arvtom/uwb_trac/README.md

# uwb_trac
My BA thesis: beacon based object tracking using UAV. Navigation is performed using UWB distance measurement. Quadcopter altitude, distance and angle to beacon is controlled using PID algorithm. Flight data is displayed in real time on a LCD display and saved to a microSD card.  

Summary can be found in .pdf slides.

Navigation diagram  
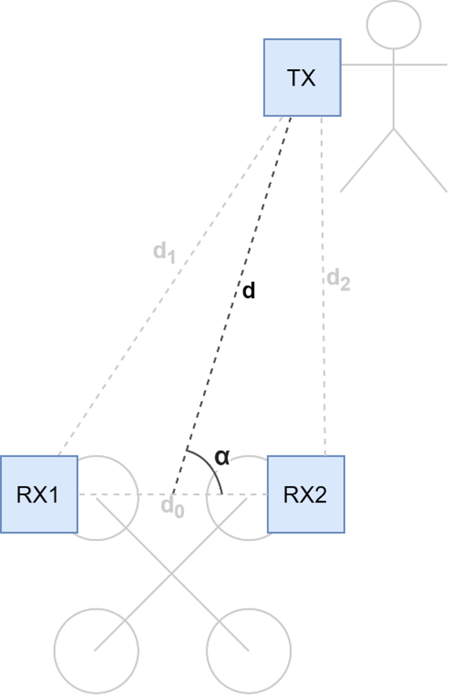
[picture p1: navigation_diagram.png]
  

HW bock diagram  
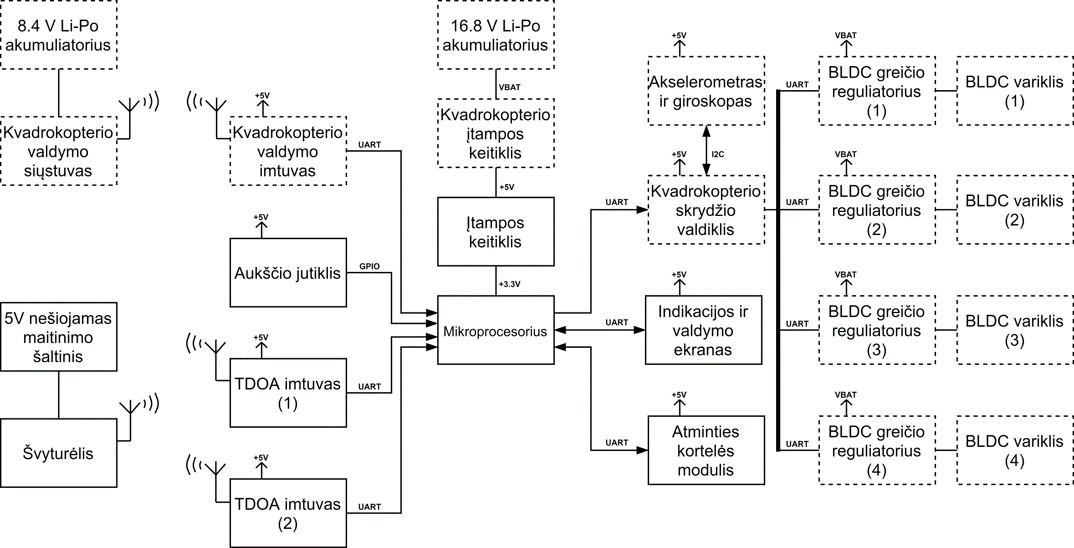
[picture p2: hw_block_diagram.png]
  

PCBA  
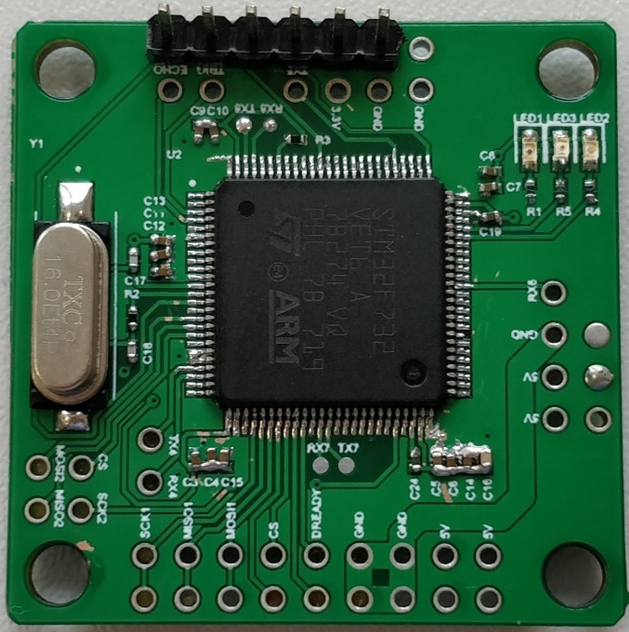
[picture p3: pcba.jpg]
  

Equipment  
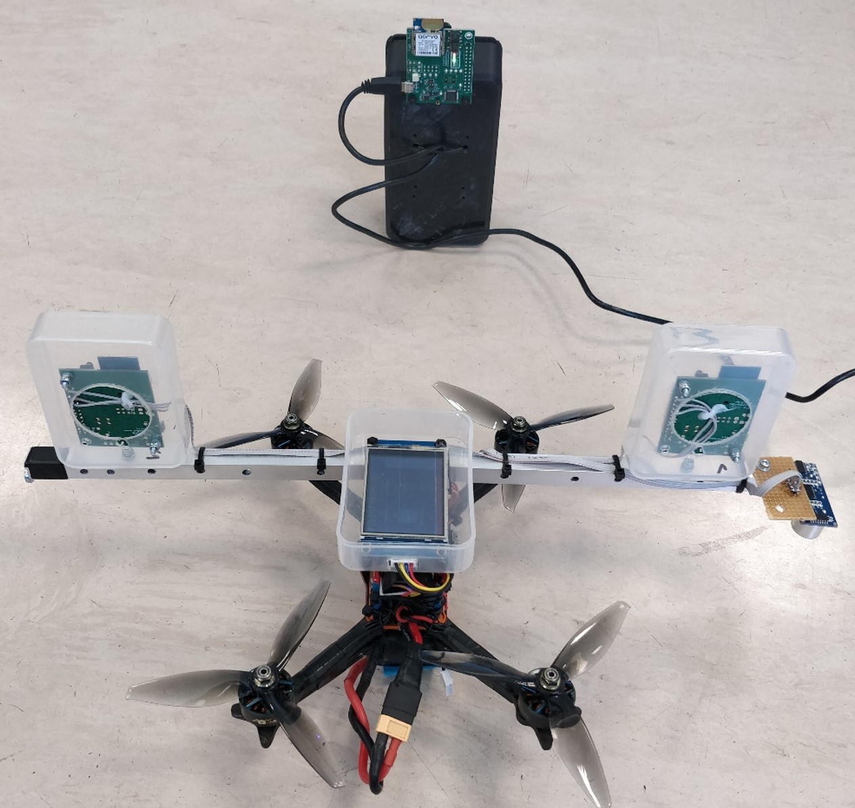
[picture p4: equipment.jpg]
