arvtom/uwb_trac/Objekto su švyturėliu sekimas naudojant bepilotį orlaivį_slides.pdf

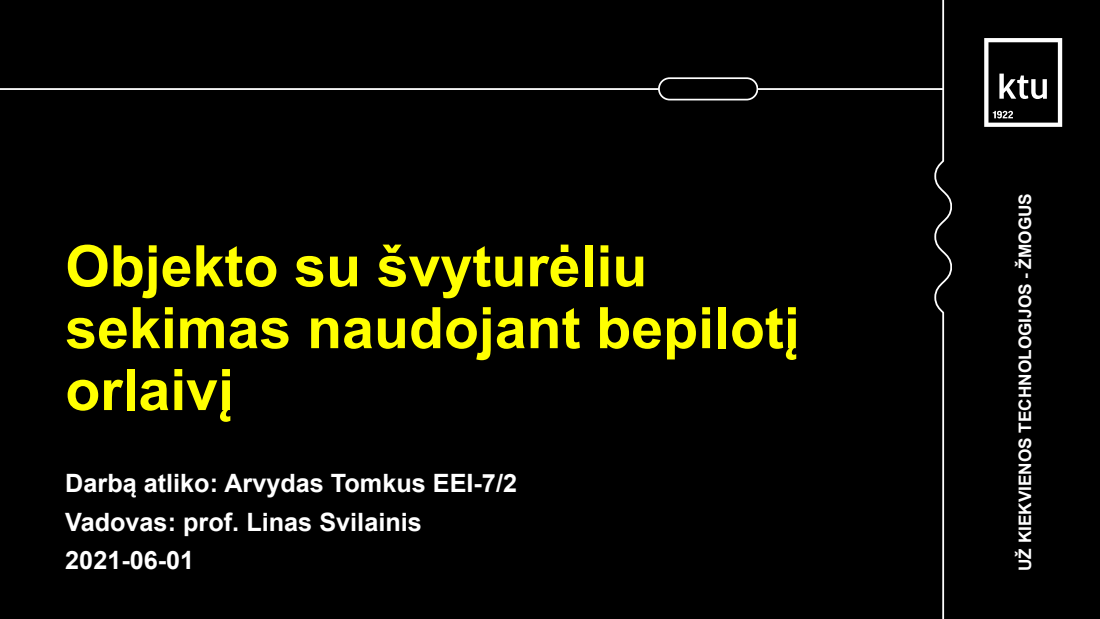
[picture p5: page 1]

UŽ KIEKVIENOS TECHNOLOGIJOS - ŽMOGUS

Objekto su švyturėliu
sekimas naudojant bepilotį
orlaivį

Darbą atliko: Arvydas Tomkus EEI
Vadovas: prof. Linas Svilainis

## Darbo tikslas ir užduotys

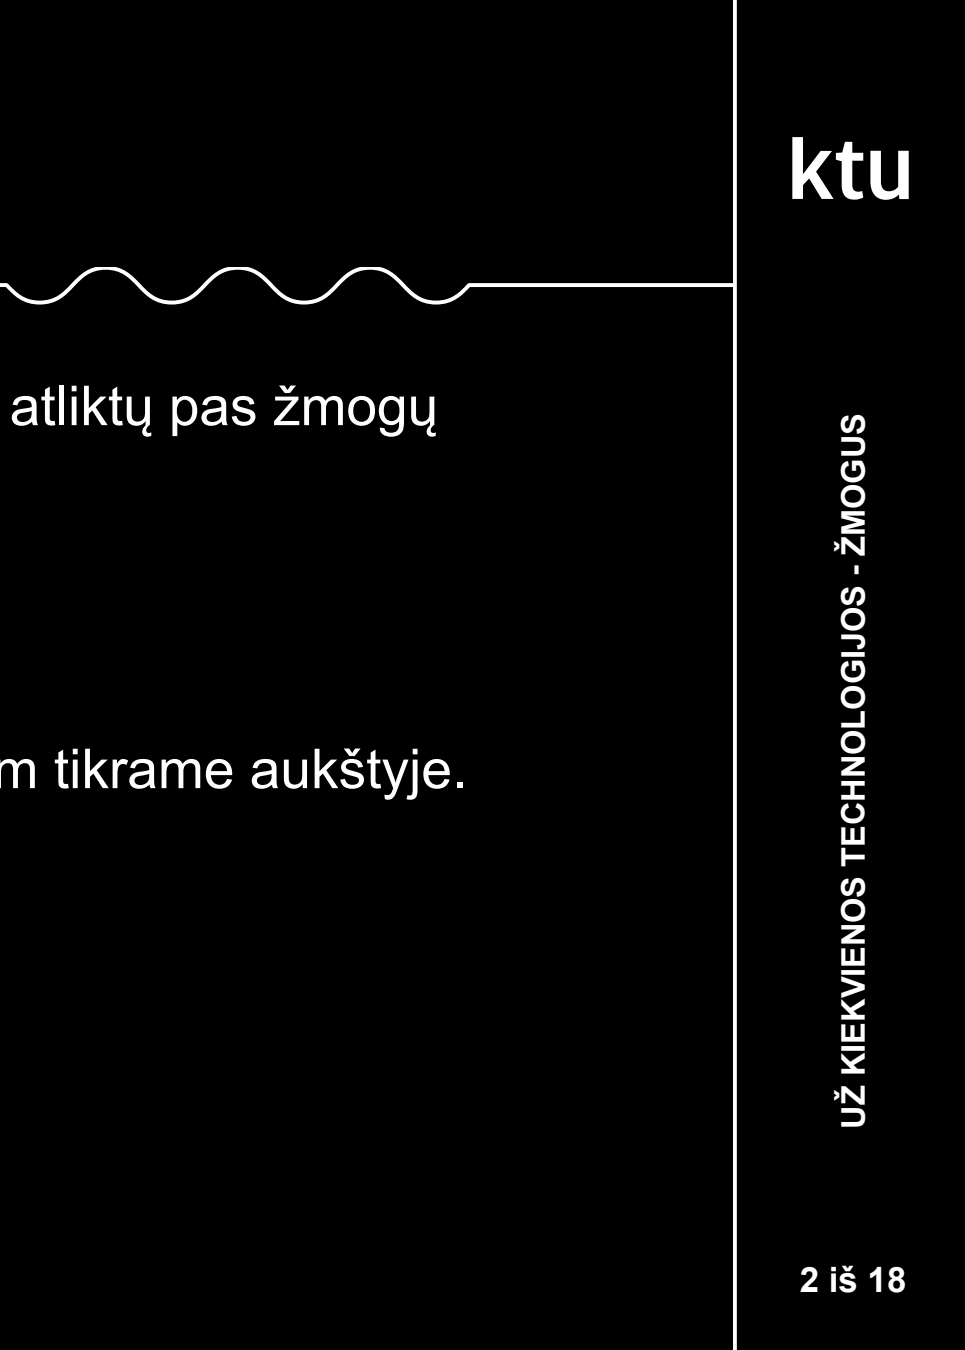
[picture p6: figure]
UŽ KIEKVIENOS TECHNOLOGIJOS - ŽMOGUS

Suprojektuoti kvadrokopterį papildančią sistemą, kuri atliktų pas žmogų prisegto švyturėlio sekimą.

1. Išmatuoti atstumą ir kampą į švyturėlį
2. Išmatuoti orlaivio aukštį
3. Užtikrinti švyturėlio sekimą tam tikru atstumu ir tam tikrame aukštyje.

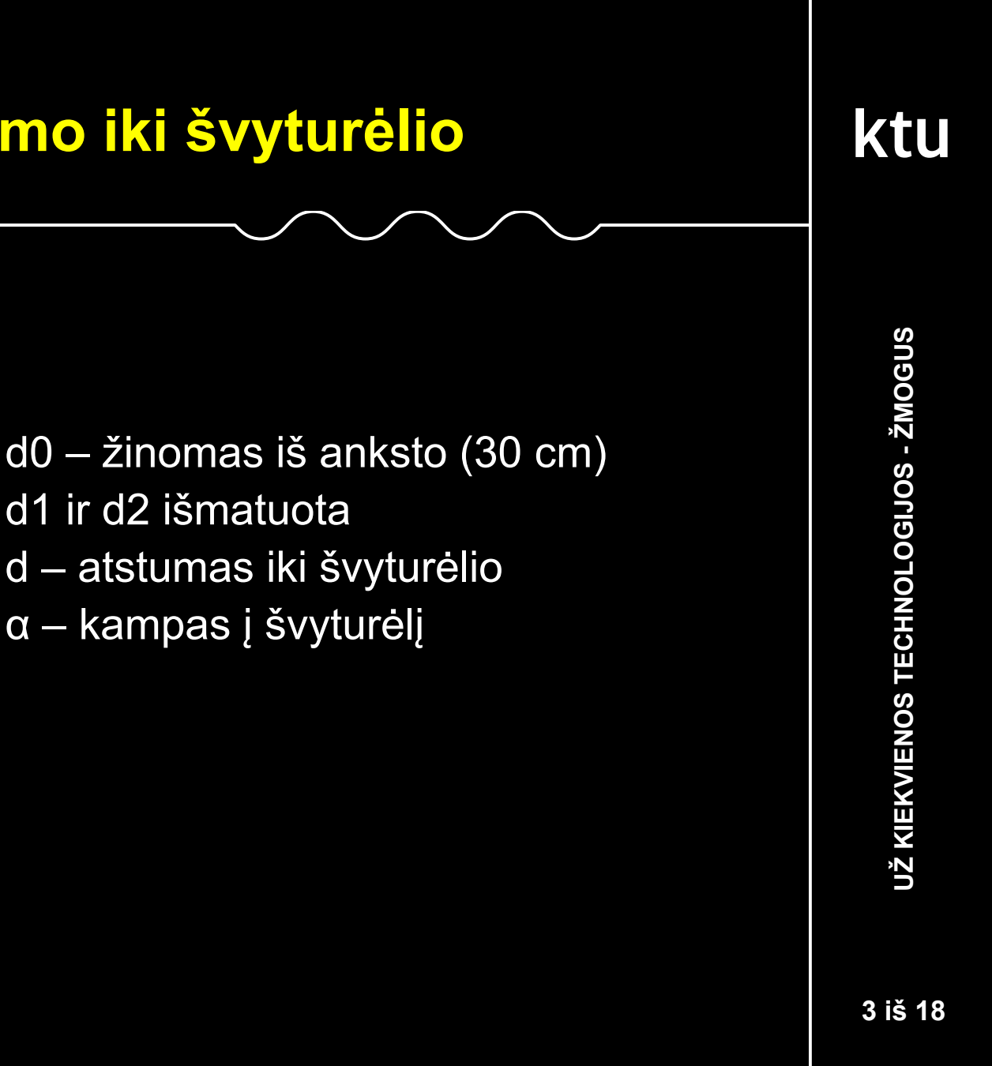
[picture p7: figure]
UŽ KIEKVIENOS TECHNOLOGIJOS - ŽMOGUS; d0 – žinomas iš anksto (30 cm) d1 ir d2 išmatuota d – atstumas iki švyturėlio α – kampas į švyturėlį

## Užduotis (1). Kampo ir atstumo iki švyturėlio matavimas

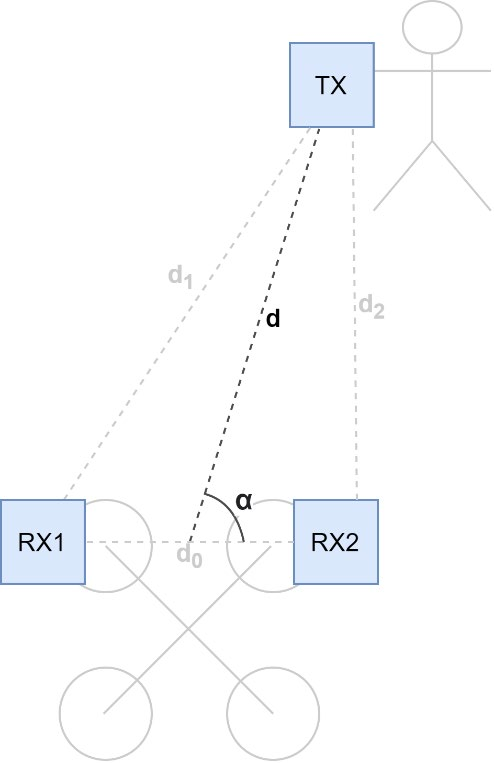
[picture p8: figure]

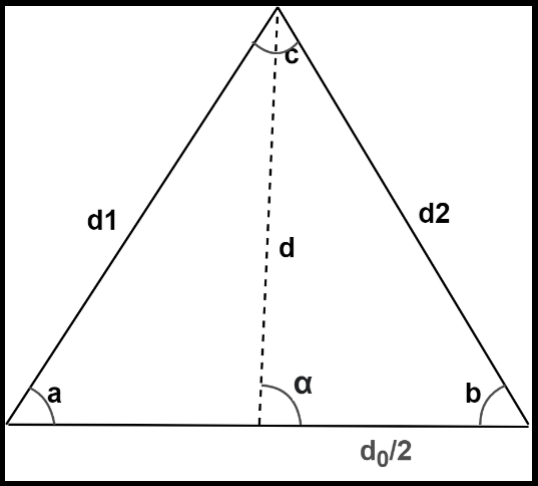
[picture p9: figure]
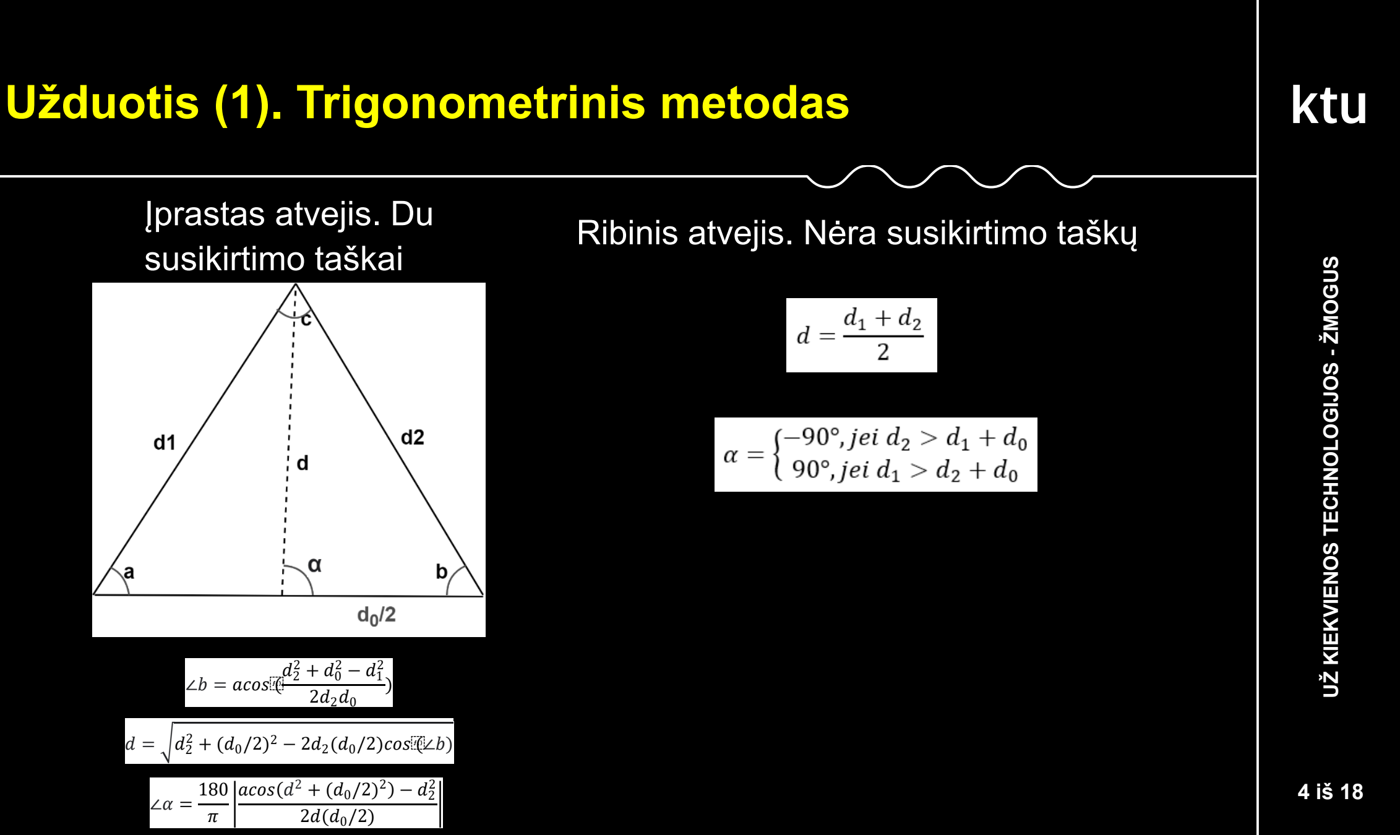
[picture p10: figure]
Užduotis (1). Trigonometrinis metodas; UŽ KIEKVIENOS TECHNOLOGIJOS - ŽMOGUS; ∠bb = aaaaaaaa⁡(; aaaaaaaa(dd2 + (dd0/2)2) − dd2 2 2dd(dd0/2) ; Įprastas atvejis. Du; susikirtimo taškai; Ribinis atvejis. Nėra susikirtimo taškų

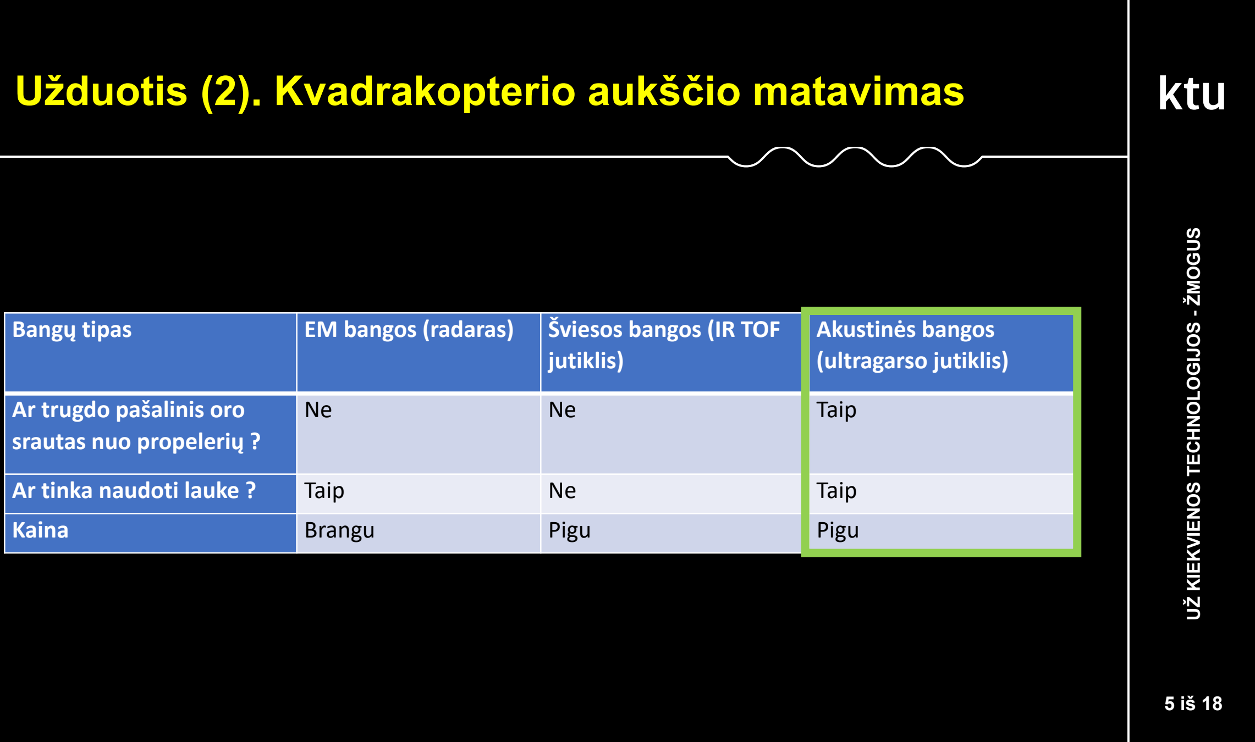
[picture p11: figure]
UŽ KIEKVIENOS TECHNOLOGIJOS - ŽMOGUS; Bangų tipas; EM bangos (radaras); Šviesos bangos (IR TOF jutiklis); Akustinės bangos (ultragarso jutiklis); Ar tinka naudoti lauke ?; Taip; Kaina; Brangu; Pigu

## Užduotis (2). Kvadrakopterio aukščio matavimas

Ar trugdo pašalinis oro srautas nuo propelerių ? | Ne | Ne | Taip

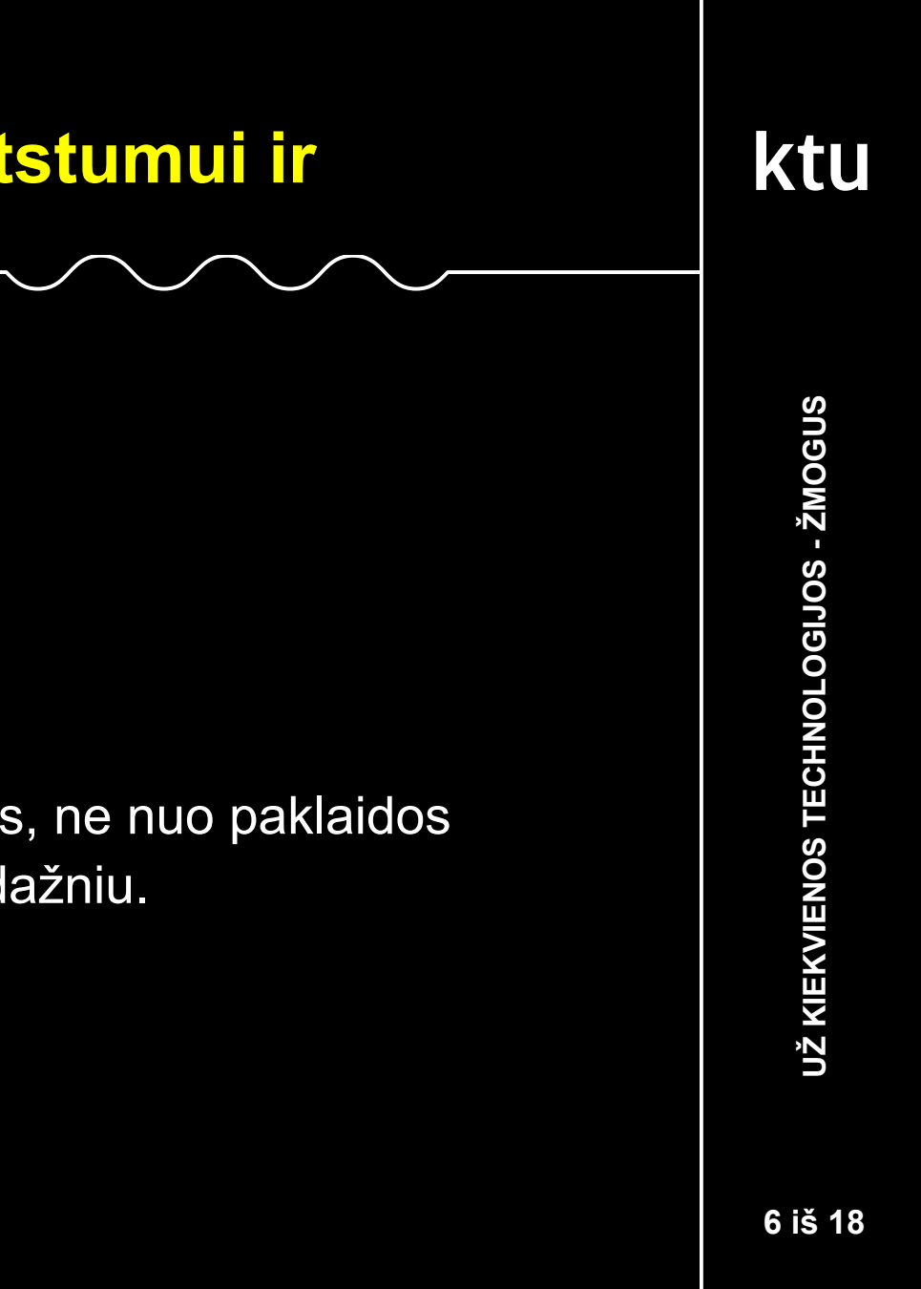
[picture p12: figure]
UŽ KIEKVIENOS TECHNOLOGIJOS - ŽMOGUS

## Užduotis (3). PID valdiklis kampui, atstumui ir aukščiui

Papildomai:
1. Apribotas PID išėjimas
2. Apribota integralo suma
3. D dedamoji skaičiuojama nuo išmatuotos vertės, ne nuo paklaidos
4. LPF D dedamosios išėjime, su 20 Hz „cut off“ dažniu.

## Sistemos struktūrinė schema

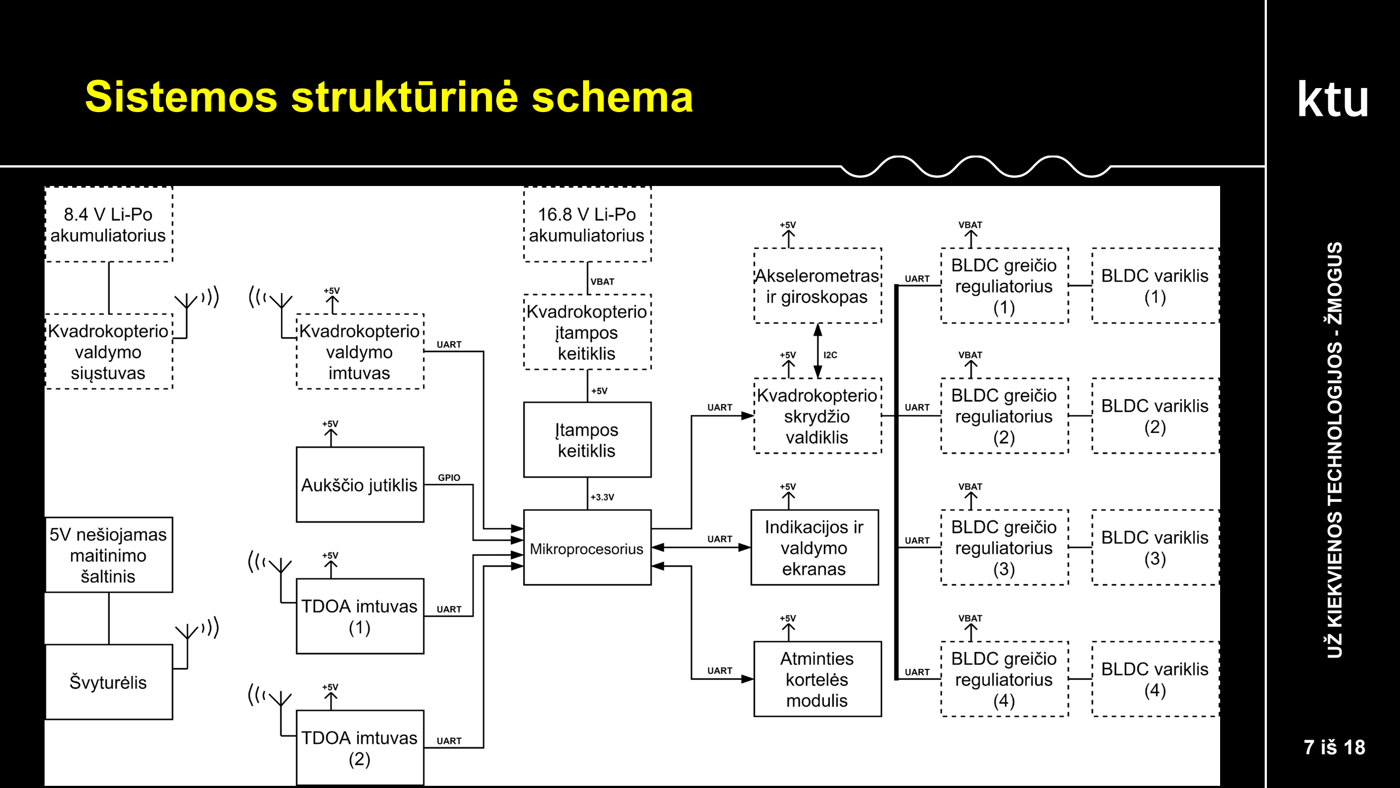
[picture p13: page 7]

7

iš 18

UŽ KIEKVIENOS TECHNOLOGIJOS - ŽMOGUS

### 8 iš 18

## Komponentų pasirinkimas (1). UWB modulis ir ultragarso jutiklis

UŽ KIEKVIENOS TECHNOLOGIJOS - ŽMOGUS

Pavadinimas | „BU01“ | „DWM1001-DEV“ | „Pozyx developer tag“
Maksimalus atstumas, m | - | 300 | 60
Atsitiktinė paklaida, cm | 10 | 10 | 10
Sąsaja | „SPI“ | „UART“, „SPI“, „Bluetooth“ | „UART“, „I2C“
Diskretizavimo dažnis, Hz | 10 | 10 | 10
Papildomi jutikliai | - | Akselerometras | Akselerometras, giroskopas, kompasas
Plėtojimo plokštės kaina, Eur | 18 | 20 | 135
Atskiro modulio kaina, Eur | 10 | 25 | -
Pavadinimas | HC-SR04 | GY-US42 | EV_MOD_CH101-01-02
Maksimalus atstumas, m | 4 | 7.5 | 1.2
Atsitiktinė paklaida, mm | 3 | 10 | 1
Matymo kampas, ° | 15 | 10 | 45
Sąsaja | „PWM“ | „I2C“, „UART“, „PWM“ | „I2C“
Diskretizavimo dažnis, Hz | 16 | 15 | 100
Kaina, Eur | 3.5 | 7 | 18

### 9 iš 18

## Komponentų pasirinkimas (2). Mikroprocesorius

UŽ KIEKVIENOS TECHNOLOGIJOS - ŽMOGUS
Pavadinimas | „STM32L053C8U6“ | „STM32F303ZDT6“ | „STM32F732VET6“
Taktinis dažnis, MHz | 32 | 72 | 216
Taimerių kiekis | 9 | 14 | 18
Laikinoji atmintis, kB | 8 | 64 | 256
Flash atmintis, kB | 64 | 512 | 512
„SPI“ kiekis | 4 | 4 | 5
„UART“ kiekis | 2 | 5 | 4
Palaiko „UART“ priėmimo loginį invertavimą | Taip | Taip | Taip
Korpusas | „LQFP-48“ | „LQFP-144“ | „LQFP-100“
Kaina, Eur | 3.25 | 7.91 | 8.79

### 10 iš 18

## Komponentų pasirinkimas (3). Ekranas ir atminties kortelė

UŽ KIEKVIENOS TECHNOLOGIJOS - ŽMOGUS

Pavadinimas | „AST1032“ | „NX3224T024“
Istrižainė, coliai | 0.96 | 2.4
Technologija | OLED | TFT LCD
Valdymo sąsaja | „I2C“ | „UART“
Rezoliucija | 128x64 | 320x240
Srovės suvartojimas, mA | 15 | 90
Lietimo sensorius | - | Yra
Kaina, Eur | 6.55 | 18
Pavadinimas | „Adafruit MicroSD card breakout board+“ | „Sparkfun Openlog“
Valdymo sąsaja | „SPI“ | „UART“
Maksimalus greitis | - | 115.2 kbit/s
Palaikoma failų sistema | „FAT16“, „FAT32“ | „FAT16“, „FAT32“
Kaina, Eur | 6.55 | 18

## Spausdinto montažo plokštė

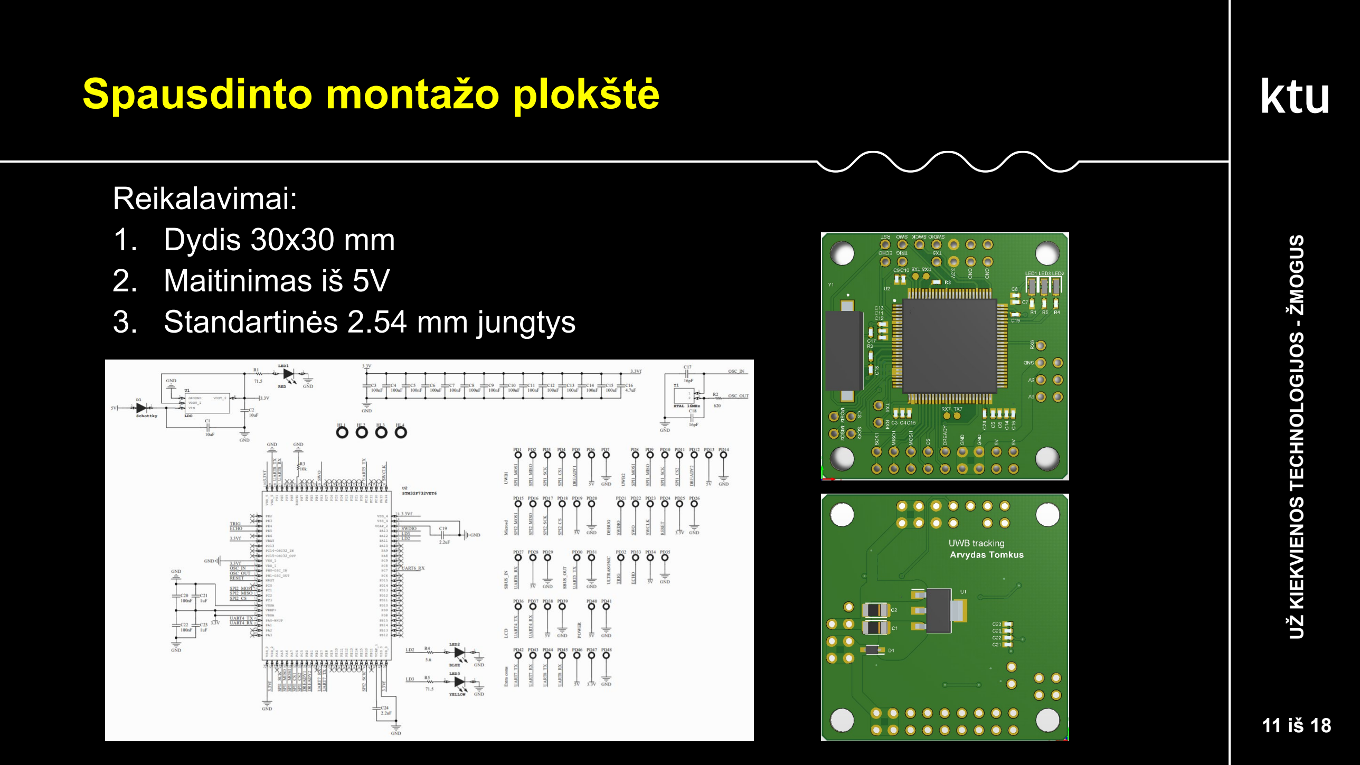
[picture p14: page 11]

11

iš 18

UŽ KIEKVIENOS TECHNOLOGIJOS - ŽMOGUS

Reikalavimai:
1. Dydis 30x30 mm
2. Maitinimas

iš 5V
3. Standartinės 2.54 mm jungtys

## Programinis algoritmas

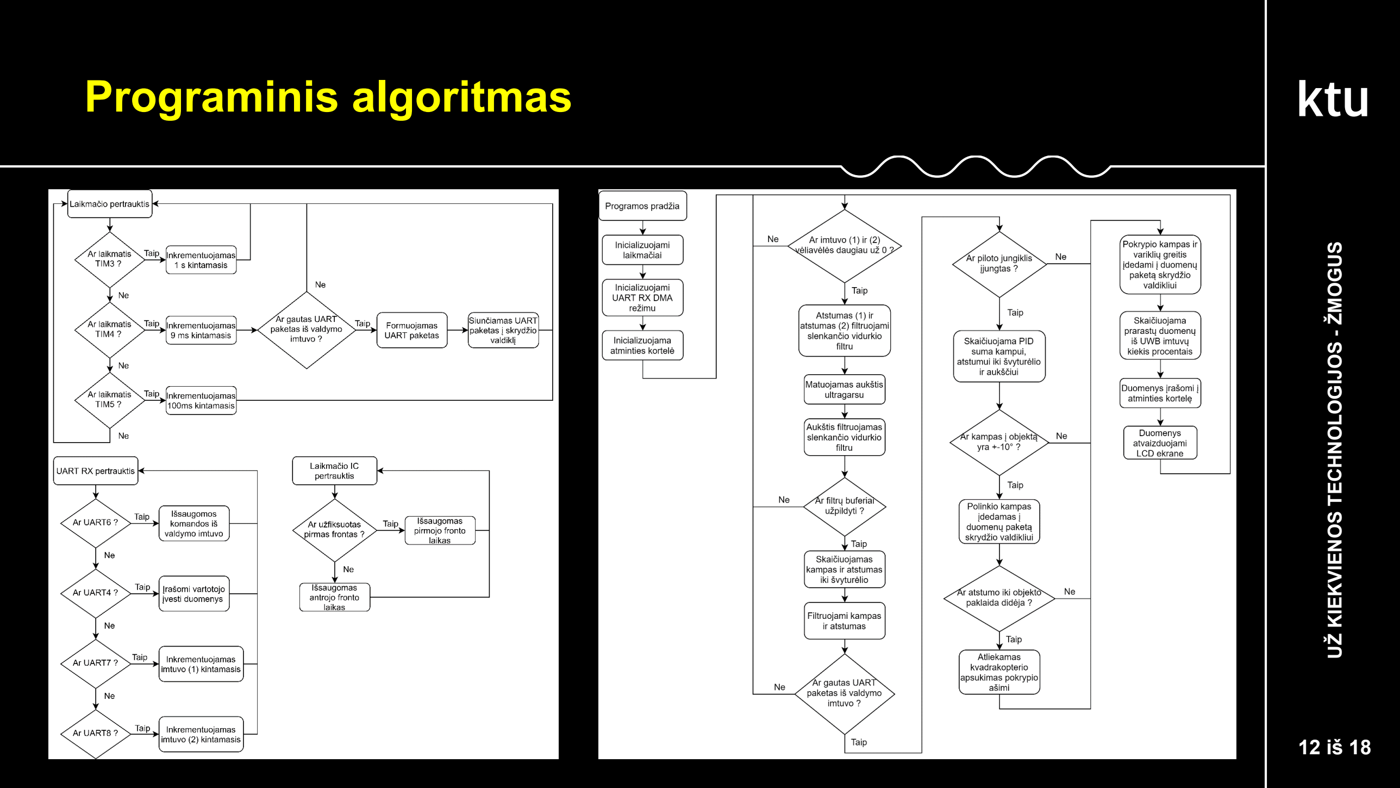
[picture p15: page 12]

12

iš 18

UŽ KIEKVIENOS TECHNOLOGIJOS - ŽMOGUS

## Rezultatai (1)

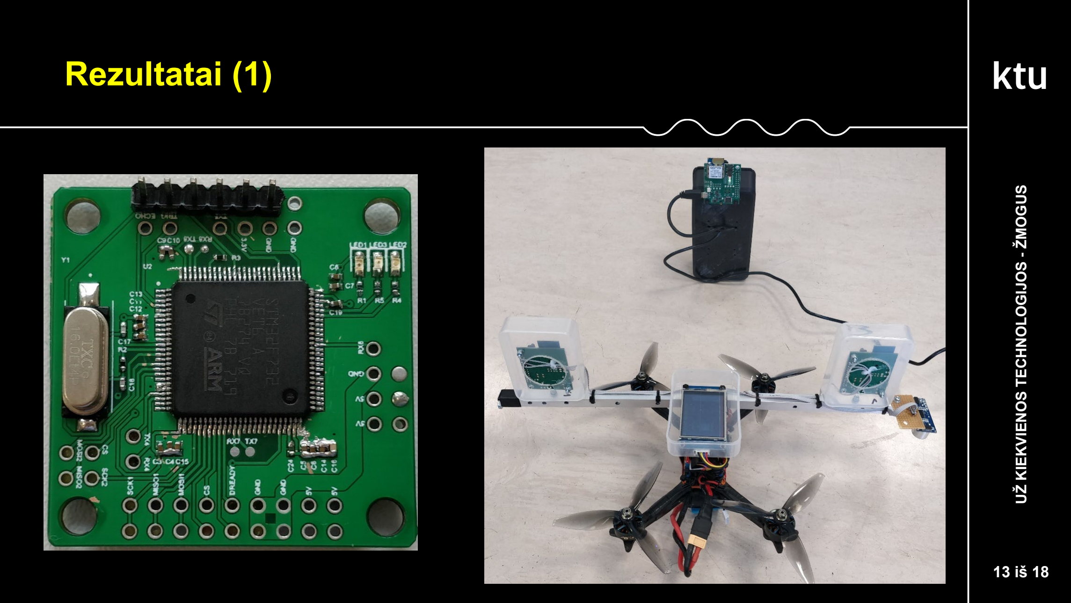
[picture p16: page 13]

13

iš 18

UŽ KIEKVIENOS TECHNOLOGIJOS - ŽMOGUS

## Rezultatai (2). Praktinės paklaidos

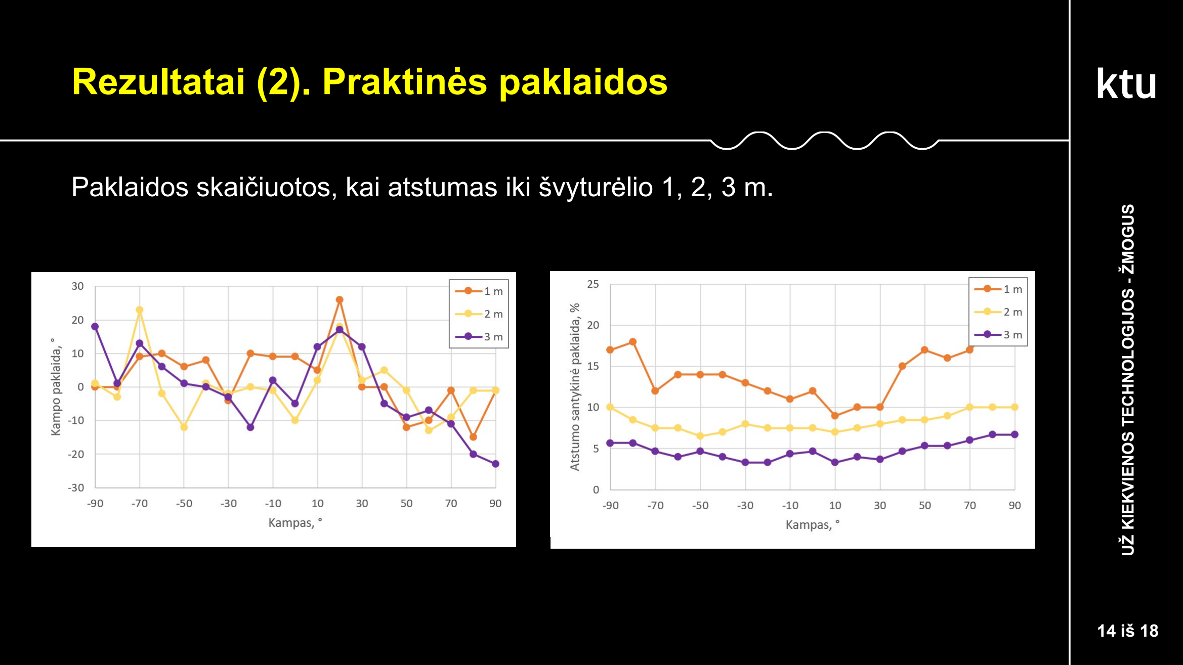
[picture p17: page 14]

14

iš 18

UŽ KIEKVIENOS TECHNOLOGIJOS - ŽMOGUS

Paklaidos skaičiuotos, kai atstumas iki švyturėlio 1, 2, 3 m.

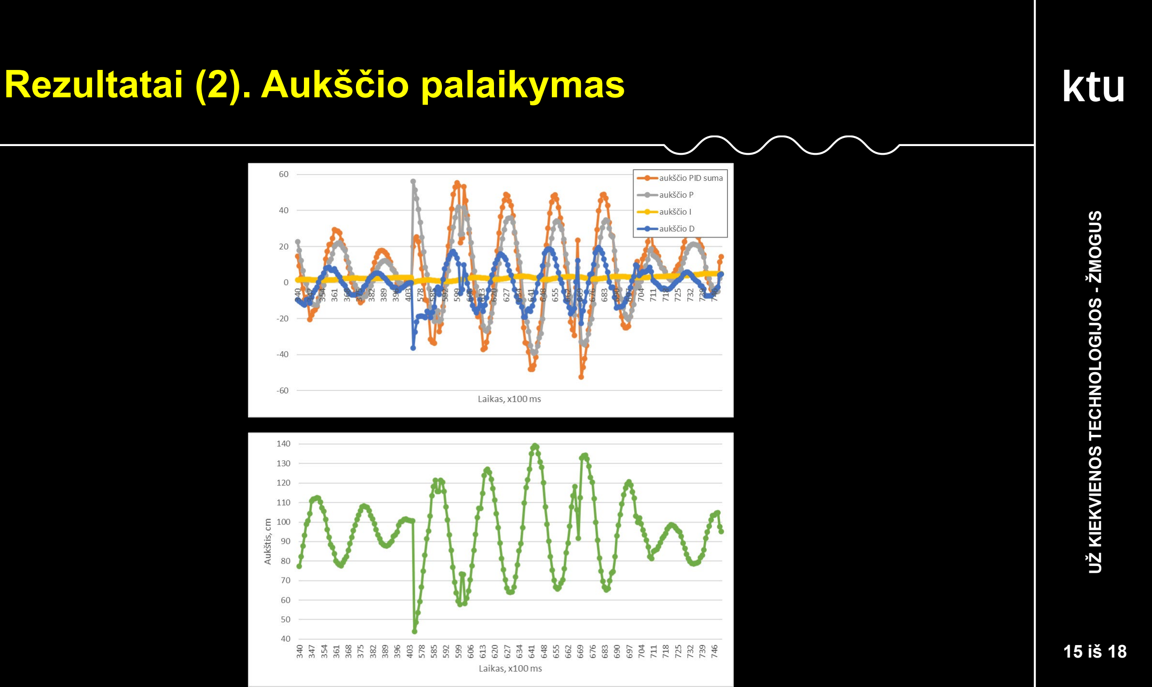
[picture p18: figure]
Rezultatai (2). Aukščio palaikymas; UŽ KIEKVIENOS TECHNOLOGIJOS - ŽMOGUS

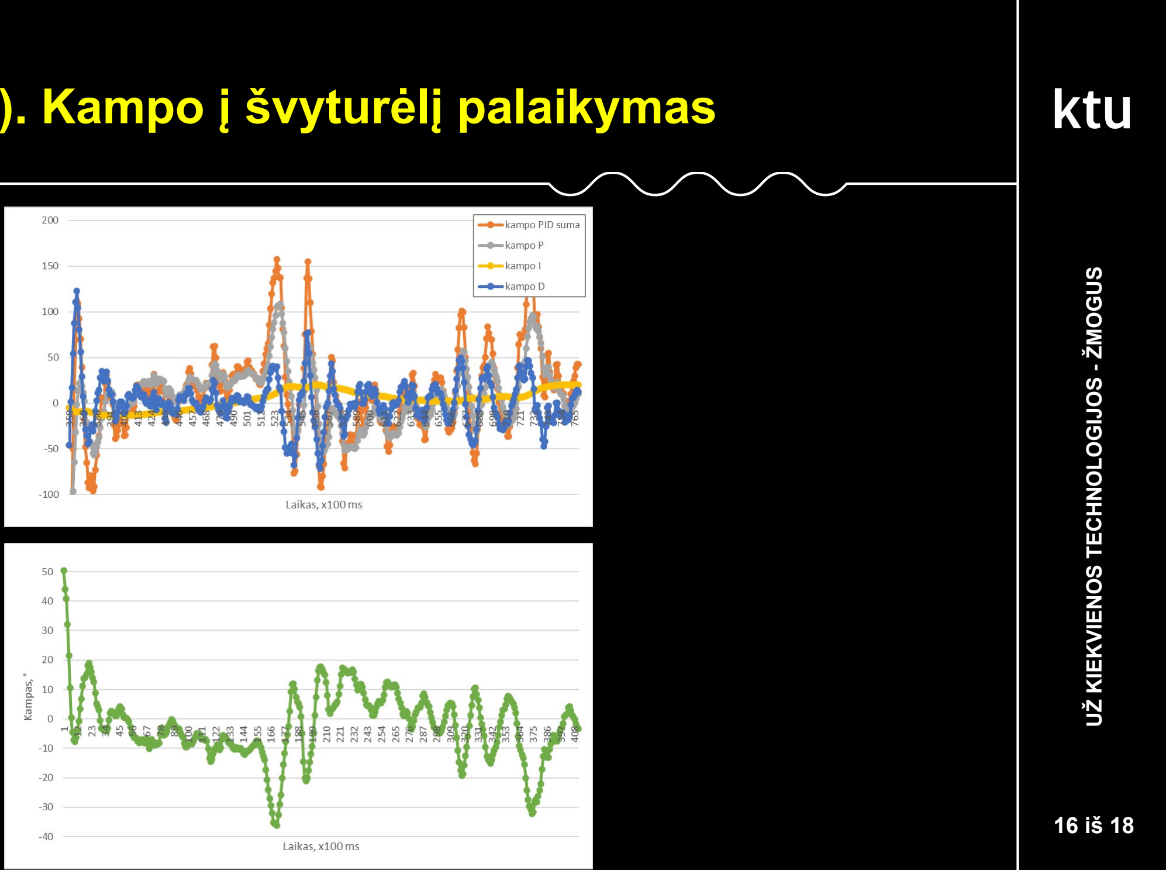
[picture p19: figure]
UŽ KIEKVIENOS TECHNOLOGIJOS - ŽMOGUS

## Rezultatai (3). Kampo į švyturėlį palaikymas

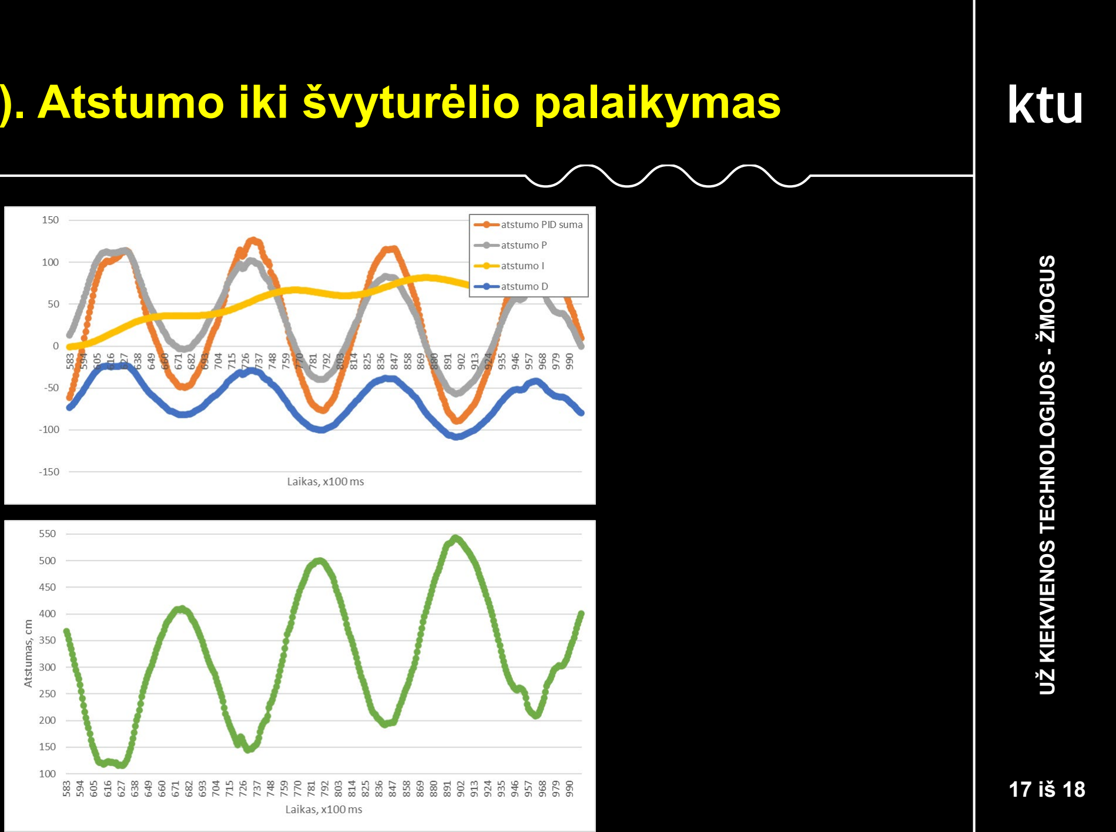
[picture p20: figure]
UŽ KIEKVIENOS TECHNOLOGIJOS - ŽMOGUS

## Rezultatai (4). Atstumo iki švyturėlio palaikymas

## Išvados

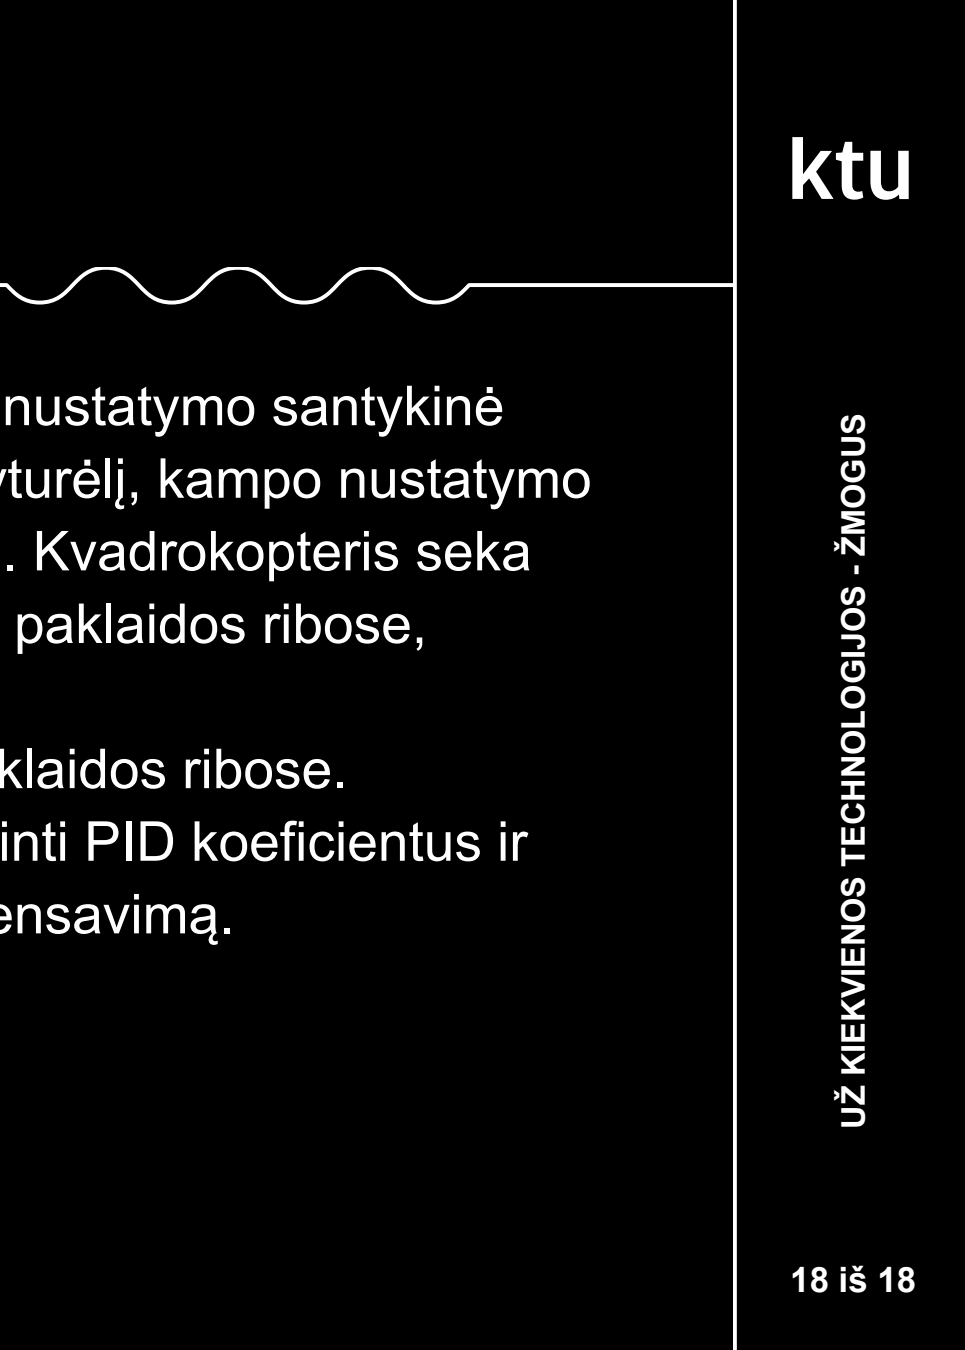
[picture p21: figure]
UŽ KIEKVIENOS TECHNOLOGIJOS - ŽMOGUS

1. Kampo nustatymo paklaida siekia 20°, o atstumo nustatymo santykinė paklaida siekia 10%. Tačiau esant 0° kampui į švyturėlį, kampo nustatymo paklaida 10°, o atstumo nustatymo paklaida 7.5%. Kvadrokopteris seka švyturėlį palaikydamas užduotą atstumą ±150 cm paklaidos ribose, kampą ±15° paklaidos ribose.
2. Kvadrokopteris palaiko užduotą aukštį ±40 cm paklaidos ribose.
3. Reikalingi tolimesni eksperimentai, siekiant suderinti PID koeficientus ir sumažinti aukščio ir atstumo palaikymo perkompensavimą.
