arvtom/uwb_trac/UWB pcb/Core/Src/main.c

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
/* Includes ------------------------------------------------------------------*/
#include "main.h"

/* USER CODE BEGIN Includes */
#include <stdio.h>
#include <string.h>
#include <math.h>
#include <stdlib.h>
/* USER CODE END Includes */

/* USER CODE BEGIN PTD */
#define usTIM TIM8
/* USER CODE END PTD */

/* USER CODE BEGIN PD */
#define MAX_ANCHORS 4
#define SBUS_TX_LENGTH 25
#define SBUS_RX_LENGTH2 25*2
#define SBUS_RX_LENGTH 25
#define SBUS_START 0x0f
#define SBUS_END 0x00
#define SBUS_CHANNELS 16
#define SBUS_CHANNEL_MIN 173
#define SBUS_CHANNEL_MAX 1812
#define PID_MAX 500
#define PID_MIN -500
#define RC_MAX 2000
#define RC_MIN 1000
#define UWB_UART_LENGTH 12
#define UWB_PACKET_BUFFER_SIZE 20
#define UWB_MAX_PACKET_LOSS 50
#define LOG_LENGTH 200
#define SPI_RX_DATA_SIZE 90
#define SPI_RX_BUF_SIZE 90
#define SPI_TX_BUF_SIZE 90
#define ULTRASONIC_TIMEOUT_MS 20
#define ULTRASONIC_MIN_DISTANCE_CM 5
#define ULTRASONIC_MAX_DISTANCE_CM 500
//#define ULTRASONIC_FILTER_SIZE 5
#define MAX_FILTER_SIZE 10
#define UWB_FILTER_SIZE 2
//#define TRIG_ANGLE_FILTER_SIZE 5
//#define TRIG_DISTANCE_FILTER_SIZE 2
#define UWB_RX_TO_RX_DISTANCE_CM 29.5
#define pi 3.14159
#define conv_to_deg 180/pi
#define PID_period 0.1 //seconds
//ALTITUDE SETTINGS
#define SETPOINT_ALTITUDE 100 //cm
#define DEADZONE_ALTITUDE 10;
//#define P_altitude 0.1
#define USONIC_FILTER_SIZE 2
#define P_altitude 1
#define I_altitude 0.05
#define D_altitude 0.05
#define PID_MIN_ALT -200
#define PID_MAX_ALT 200
#define PID_MIN_ALT_I -50
#define PID_MAX_ALT_I 50
//ANGLE SETTINGS
#define SETPOINT_ANGLE 0 //degrees
#define DEADZONE_ANGLE 20
#define TRIG_ANGLE_FILTER_SIZE 10
#define P_angle 3
#define I_angle 0.25
#define D_angle 0.3
//DISTANCE SETTINGS
#define SETPOINT_DISTANCE 400 //cm
#define TRIG_DISTANCE_FILTER_SIZE 2
#define P_distance 2
#define I_distance 0.025
#define D_distance 0.03
#define D_FILTER_TIME_CONSTANT 0.0106
//DISPLAY SETTINGS
#define DISPLAY_RX_LENGTH 7
#define DISPLAY_TX_LENGTH 13
#define DISPLAY_START_PERIODIC 0x5a
#define DISPLAY_START_ANGLE_PID 0x5b
#define DISPLAY_START_DISTANCE_PID 0x5c
#define DISPLAY_START_ALTITUDE_PID 0x5d
#define DISPLAY_START_FLIGHT_SETTINGS 0x5e
#define MICROSD_BUFFER_SIZE 1000
#define PIDSUM_MAX 500
#define PIDSUM_MIN -500
#define MAX_DROPPED_SBUS_PACKETS 4
#define U_TURN_DURATION 10//x100ms
/* USER CODE END PD */


TIM_HandleTypeDef htim3;
TIM_HandleTypeDef htim4;
TIM_HandleTypeDef htim5;
TIM_HandleTypeDef htim8;
TIM_HandleTypeDef htim9;

UART_HandleTypeDef huart4;
UART_HandleTypeDef huart5;
UART_HandleTypeDef huart7;
UART_HandleTypeDef huart8;
UART_HandleTypeDef huart3;
UART_HandleTypeDef huart6;
DMA_HandleTypeDef hdma_uart7_rx;
DMA_HandleTypeDef hdma_uart8_rx;
DMA_HandleTypeDef hdma_usart6_rx;

/* USER CODE BEGIN PV */
uint8_t begin_tracking = 0;
float last_state_rcin6 = 1000;
char microsd_buf[MICROSD_BUFFER_SIZE];
uint16_t microsd_buf_size = 0;
//Timers
uint32_t time_10hz = 0;
uint32_t last_time_10hz = 0;
uint32_t delay = 0;
volatile uint8_t tmr_flag_1s = 0;
volatile uint8_t tmr_flag_9ms = 0;
volatile uint8_t tmr_flag_100ms = 0;
uint8_t arm_flag = 0;
uint8_t uart_error = 0;
uint8_t rxUART7[UWB_UART_LENGTH] = {0};//UWB1 buferis
uint8_t rxUART8[UWB_UART_LENGTH] = {0};//UWB2 buferis
uint8_t rxUART6[SBUS_RX_LENGTH2] = {0};//uart buferis
uint8_t txUART5[SBUS_TX_LENGTH] = {0};
uint8_t txUART7[LOG_LENGTH] = {0};
uint8_t rxUART4[DISPLAY_RX_LENGTH] = {0};
uint8_t txUART4[DISPLAY_TX_LENGTH] = {0};
uint8_t display_flag = 0;
//SBUS variables
uint8_t sbus_receive_length = SBUS_RX_LENGTH2;
uint8_t sbus_frame_start = 0;
uint8_t rc_bad_frame = 0;
uint8_t rc_packets = 0;
uint8_t rc_no_pulses = 0;
uint16_t rc_in_raw[SBUS_CHANNELS] = {0};
uint16_t rc_out_raw[SBUS_CHANNELS] = {0};
float rc_in[SBUS_CHANNELS] = {0};
float rc_out[SBUS_CHANNELS] = {0};
uint8_t rc_frame_lost = 0;
uint8_t rc_failsafe = 0;
//UWB variables
uint8_t uwb1_uart_received = 0;
uint8_t uwb2_uart_received = 0;
struct loc
{
	uint32_t node_pos_x;
	uint32_t node_pos_y;
	uint32_t node_pos_z;
	uint32_t node_pos_qf;//quality factor
	uint8_t distances_amount;//how many distances are being sent
	//From here data should be arrays, if more than one anchor is used
	uint16_t anchor_uwb_address[MAX_ANCHORS];
	uint32_t distance_to_anchor[MAX_ANCHORS];
	float distance_to_anchor_cm[MAX_ANCHORS];
	uint8_t distance_to_anchor_qf[MAX_ANCHORS];//quality factor
	uint32_t anchor_pos_x[MAX_ANCHORS];
	uint32_t anchor_pos_y[MAX_ANCHORS];
	uint32_t anchor_pos_z[MAX_ANCHORS];
	uint32_t anchor_pos_qf[MAX_ANCHORS];//quality factor
	uint32_t last_distance_to_anchor[MAX_ANCHORS];
	uint8_t uwb_ok[MAX_ANCHORS];
	uint16_t packet_sum[MAX_ANCHORS];
	uint16_t packet_loss[MAX_ANCHORS];
};
struct loc dwm_loc_get1;
struct loc dwm_loc_get2;
//Ultrasonic variables
uint8_t IC_flag = 0;
uint8_t IC_index = 0;
uint32_t IC_time1 = 0;
uint32_t IC_time2 = 0;
const float speed_of_sound = 0.0343/2;
float ultrasonic_distance_cm = 0;
uint32_t usonic_distance_cm_uint32 = 0;
struct f_float
{
	float value;
	float moving_sum;
	uint8_t window_index;
	float buf[MAX_FILTER_SIZE];
	uint8_t buf_size;
	uint8_t filter_size;
};
struct f_float f_uwb1_cm;
struct f_float f_uwb2_cm;
struct f_float f_usonic_cm;
struct f_float f_trig_angle_deg;
struct f_float f_trig_distance_cm;
float last_dist_error = 0;//naudojama detektuoti, kada skrenda ne i ta puse
uint8_t wrong_side = 0;
uint8_t good_side = 0;
uint8_t u_turn = 0;
uint8_t u_turn_duration = 0;
//Bilateration variables
float bilat_x_est_cm = 0;
float bilat_y_est_cm = 0;
float bilat_rho_est_cm = 0;
float bilat_theta_est_deg = 0;
//Trigonometrinio variables
float trig_rho_est_cm = 0;
float trig_theta_est_deg = 0;
//struct pid
//{
//	float error;
//	float last_error;
//	float integral;
//	float derivative;
//	float pidsum;
//	float Kp;
//	float Ki;
//	float Kd;
//	float psum;
//	float isum;
//	float dsum;
//	float deadzone;
//};
//struct pid pid_altitude;
//struct pid pid_distance;
//struct pid pid_angle;
struct pid
{
	float plusminus;
	float Kp;
	float Ki;
	float Kd;
	float tau;//D low pass filtro laiko konstanta
	float lim_min;
	float lim_max;
	float lim_min_int;
	float lim_max_int;
	float T;
	float psum;
	float isum;
	float dsum;
	float error;
	float last_error;
	float last_meas;
	float pidsum;
};
struct pid pid_altitude;
struct pid pid_distance;
struct pid pid_angle;
float test_altitude = 101;//cm
float test_distance = 3049;//mm
float test_angle = 91;//degrees
float setpoint_altitude = SETPOINT_ALTITUDE;//cm
float setpoint_distance = SETPOINT_DISTANCE;//cm
float setpoint_angle = SETPOINT_ANGLE;//degrees
uint8_t object_tracking = 0;
float tracking_thr = 1000;
float control_thr = 0;//1000:2000
float control_pitch = 0;//1000:2000
float control_yaw = 0;//1000:2000
uint8_t target_locked = 0;// =1 when angle is within deadzone
/* USER CODE END PV */

void SystemClock_Config(void);
static void MX_GPIO_Init(void);
static void MX_DMA_Init(void);
static void MX_UART4_Init(void);
static void MX_TIM3_Init(void);
static void MX_TIM4_Init(void);
static void MX_TIM5_Init(void);
static void MX_TIM8_Init(void);
static void MX_TIM9_Init(void);
static void MX_UART5_Init(void);
static void MX_USART6_UART_Init(void);
static void MX_UART7_Init(void);
static void MX_UART8_Init(void);
static void MX_USART3_UART_Init(void);
/* USER CODE BEGIN PFP */
void usDelay(uint32_t uSec);
void measure_ultrasonic();
void read_sbus();
void write_sbus();
void sbus_passthrough();
void init_variables();
void moving_average_update_float(float input, struct f_float *s);
void update_trig(float B, float A);
void init_log_microsd();
void update_log_microsd();
void write_periodic_LCD();
float constrain_f(float input, float min, float max);
//void calculate_PID(float measured, float setpoint, struct pid *s);
void parse_uwb_uart(struct loc *loc, uint8_t bfr[]);
void init_PID(struct pid *s);
void calculate_PID(float measurement, float setpoint, struct pid *s);
/* USER CODE END PFP */

/* USER CODE BEGIN 0 */
void detect_wrong_side()
{
	if(abs(pid_distance.error)>last_dist_error)
	{
	  wrong_side++;
	}
	else
	{
	  good_side++;
	}
	if(good_side > 5)
	{
	  wrong_side=0;
	  good_side=0;
	}
	if(wrong_side > 20)
	{
		//make a U turn
		u_turn = 1;
	}
	last_dist_error=abs(pid_distance.error);
}
/* USER CODE END 0 */

/**
  * @brief  The application entry point.
  * @retval int
  */
int main(void)
{
  /* MCU Configuration--------------------------------------------------------*/

  /* Reset of all peripherals, Initializes the Flash interface and the Systick. */
  HAL_Init();

  /* Configure the system clock */
  SystemClock_Config();

  /* Initialize all configured peripherals */
  MX_GPIO_Init();
  MX_DMA_Init();
  MX_UART4_Init();
  MX_TIM3_Init();
  MX_TIM4_Init();
  MX_TIM5_Init();
  MX_TIM8_Init();
  MX_TIM9_Init();
  MX_UART5_Init();
  MX_USART6_UART_Init();
  MX_UART7_Init();
  MX_UART8_Init();
  MX_USART3_UART_Init();
  /* USER CODE BEGIN 2 */
	HAL_TIM_Base_Start_IT(&htim3);//periodas 1s
	HAL_TIM_Base_Start_IT(&htim4);//periodas 9ms
	HAL_TIM_Base_Start_IT(&htim5);//periodas 100ms
	sbus_receive_length = SBUS_RX_LENGTH;
//	HAL_UART_Receive_DMA(&huart4, (uint8_t *)rxUART4, DISPLAY_RX_LENGTH);
	init_variables();
	init_log_microsd();
	HAL_Delay(1000);
	//	HAL_UART_Receive_DMA(&huart4, (uint8_t *)rxUART4, DISPLAY_RX_LENGTH);
	HAL_UART_Receive_DMA(&huart6, (uint8_t *)rxUART6, sbus_receive_length);//Receiver
	HAL_UART_Receive_DMA(&huart7, (uint8_t *)rxUART7, UWB_UART_LENGTH);//UWB1
	HAL_UART_Receive_DMA(&huart8, (uint8_t *)rxUART8, UWB_UART_LENGTH);//UWB2
  /* USER CODE END 2 */

  /* Infinite loop */
  /* USER CODE BEGIN WHILE */
  while (1)
  {
	  if(uwb1_uart_received == 1 && uwb2_uart_received == 1)
	  {
		  uwb1_uart_received = 0;
		  uwb2_uart_received = 0;
		  HAL_GPIO_TogglePin(GPIOA, LD3_Pin);
		  parse_uwb_uart(&dwm_loc_get1,rxUART7);
		  parse_uwb_uart(&dwm_loc_get2,rxUART8);
		  //test = tmr_flag_100ms;
		  tmr_flag_100ms = 0;
		  measure_ultrasonic();
		  moving_average_update_float(ultrasonic_distance_cm, &f_usonic_cm);
		  if(dwm_loc_get1.packet_loss[0]<=UWB_MAX_PACKET_LOSS && dwm_loc_get2.packet_loss[0]<=UWB_MAX_PACKET_LOSS)
		  {
			  moving_average_update_float(dwm_loc_get1.distance_to_anchor_cm[0], &f_uwb1_cm);
			  moving_average_update_float(dwm_loc_get2.distance_to_anchor_cm[0], &f_uwb2_cm);
			  if (f_uwb1_cm.buf_size >= UWB_FILTER_SIZE && dwm_loc_get1.distance_to_anchor_cm[0] > 0 && dwm_loc_get2.distance_to_anchor_cm[0] > 0)
			  {
				  update_trig(f_uwb1_cm.value, f_uwb2_cm.value);
				  moving_average_update_float(trig_theta_est_deg, &f_trig_angle_deg);
				  moving_average_update_float(trig_rho_est_cm, &f_trig_distance_cm);
				  if (f_trig_angle_deg.buf_size >= TRIG_ANGLE_FILTER_SIZE)
				  {
					  if(rc_in[6] > 1900 && rc_no_pulses < MAX_DROPPED_SBUS_PACKETS && rc_bad_frame == 0 && rc_failsafe == 0)
					  {
						  if(object_tracking==0 && begin_tracking==1)//sekimo ijungimo momentas. Reikia, kad nepagautu kada failsafe ir paskui vel pasileidzia
						  {
							  tracking_thr = rc_in[0];
							  init_PID(&pid_distance);
							  init_PID(&pid_angle);
							  init_PID(&pid_altitude);
						  }
						  object_tracking = 1;
						  calculate_PID(f_trig_distance_cm.value, setpoint_distance, &pid_distance);
						  calculate_PID(f_trig_angle_deg.value, setpoint_angle, &pid_angle);
						  calculate_PID(f_usonic_cm.value, setpoint_altitude, &pid_altitude);
						  if(abs(pid_angle.error) < DEADZONE_ANGLE)
						  {
							  target_locked = 1;
							  //detect_wrong_side();
						  }
						  else
						  {
							  target_locked = 0;
						  }
//						  if(u_turn==1 && u_turn_duration < U_TURN_DURATION)
//						  {
//							  control_yaw = RC_MAX;//make a U turn
//							  u_turn_duration++;
//						  }
//						  else
//						  {
//							  u_turn=0;
//							  u_turn_duration=0;
//							  control_yaw = 1500 + pid_angle.pidsum;
//						  }
						  control_yaw = 1500 + pid_angle.plusminus*pid_angle.pidsum;
						  control_pitch = 1500 + pid_distance.plusminus*pid_distance.pidsum;
						  control_thr = tracking_thr + pid_altitude.plusminus*pid_altitude.pidsum;
						  update_log_microsd();
						  HAL_GPIO_TogglePin(GPIOA, LD2_Pin);
					  }
					  else
					  {
						  object_tracking = 0;
						  begin_tracking=0;
						  target_locked = 0;
					  }
					  write_periodic_LCD();
					  HAL_UART_Transmit(&huart4, (uint8_t *)txUART4, DISPLAY_TX_LENGTH, 10);
					  delay = time_10hz - last_time_10hz;
					  last_time_10hz = time_10hz;
				  }
			  }
		  }
	  }
    /* USER CODE END WHILE */

    /* USER CODE BEGIN 3 */
  }
  /* USER CODE END 3 */
}

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
/* USER CODE BEGIN 4 */
void HAL_TIM_PeriodElapsedCallback(TIM_HandleTypeDef *htim)
{
  /* Prevent unused argument(s) compilation warning */
  UNUSED(htim);

  /* NOTE : This function should not be modified, when the callback is needed,
            the HAL_TIM_PeriodElapsedCallback could be implemented in the user file
   */
	if (htim->Instance == TIM3)
	{
		tmr_flag_1s++;
	}
	else if (htim->Instance == TIM4)
	{
		if (rc_packets > 0)
		{
			rc_packets = 0;
			rc_no_pulses = 0;
			if(rc_bad_frame==0 && rc_failsafe==0)
			{
				sbus_passthrough();
				write_sbus();
				HAL_UART_Transmit(&huart5, (uint8_t *)txUART5, SBUS_TX_LENGTH, 10);
			}
		}
		else
		{
			rc_no_pulses++;
		}
	}
	else if (htim->Instance == TIM5)
	{
		tmr_flag_100ms++;
		time_10hz++;
	}
}
void HAL_TIM_IC_CaptureCallback(TIM_HandleTypeDef *htim)
{
	if(IC_index == 0) //First edge
	{
		IC_time1 = HAL_TIM_ReadCapturedValue(htim, TIM_CHANNEL_1);
		IC_index = 1;
	}
	else if(IC_index == 1) //Second edge
	{
		IC_time2 = HAL_TIM_ReadCapturedValue(htim, TIM_CHANNEL_1);
		IC_index = 0;
		IC_flag = 1;
	}
}
void HAL_UART_RxCpltCallback(UART_HandleTypeDef *huart)
{
  /* Prevent unused argument(s) compilation warning */
  UNUSED(huart);

  /* NOTE : This function should not be modified, when the callback is needed,
            the HAL_UART_RxCpltCallback can be implemented in the user file.
   */
  if (huart->Instance == USART6)
  {
	  rc_packets++;
	  read_sbus();
	  HAL_UART_Receive_DMA(&huart6, (uint8_t *)rxUART6, sbus_receive_length);
  }
  else if (huart->Instance == UART7)
  {
	  uwb1_uart_received = 1;
	  HAL_UART_Receive_DMA(&huart7, (uint8_t *)rxUART7, UWB_UART_LENGTH);
  }
  else if (huart->Instance == UART8)
  {
	  uwb2_uart_received = 1;
	  HAL_UART_Receive_DMA(&huart8, (uint8_t *)rxUART8, UWB_UART_LENGTH);
  }

//  else if (huart->Instance == UART4)
//  {
//	  HAL_UART_Receive_DMA(&huart4, (uint8_t *)rxUART4, DISPLAY_RX_LENGTH);
//  }
}
void HAL_UART_ErrorCallback(UART_HandleTypeDef *huart)
{
  /* Prevent unused argument(s) compilation warning */
  UNUSED(huart);
  uart_error++;
  if (huart->Instance == USART6)
  {
	  //HAL_UART_DMAStop()
	  HAL_UART_AbortReceive(&huart6);
	  HAL_UART_Receive_DMA(&huart6, (uint8_t *)rxUART6, sbus_receive_length);
  }
  else if (huart->Instance == UART7)
	{
		HAL_UART_AbortReceive(&huart7);
		HAL_UART_Receive_DMA(&huart7, (uint8_t *)rxUART7, UWB_UART_LENGTH);
	}
  else if (huart->Instance == UART8)
  {
	  HAL_UART_AbortReceive(&huart8);
	  HAL_UART_Receive_DMA(&huart8, (uint8_t *)rxUART8, UWB_UART_LENGTH);
  }
//  else if (huart->Instance == UART4)
//  {
//	  HAL_UART_AbortReceive(&huart4);
//	  HAL_UART_Receive_DMA(&huart4, (uint8_t *)rxUART4, DISPLAY_RX_LENGTH);
//  }
  /* NOTE : This function should not be modified, when the callback is needed,
            the HAL_UART_ErrorCallback can be implemented in the user file.
   */
}
void usDelay(uint32_t uSec)
{
	if(uSec < 2) uSec = 2;
	usTIM->ARR = uSec - 1;
	usTIM->EGR = 1;
	usTIM->SR &= ~1;
	usTIM->CR1 |= 1;
	while((usTIM->SR&0x0001) != 1);
	usTIM->SR &= ~(0x0001);
}
void measure_ultrasonic()
{
	//Reset TRIG
	HAL_GPIO_WritePin(TRIG_GPIO_Port, TRIG_Pin, GPIO_PIN_RESET);
	usDelay(3);
	//10us impulse on TRIG
	HAL_GPIO_WritePin(TRIG_GPIO_Port, TRIG_Pin, GPIO_PIN_SET);
	usDelay(10);
	HAL_GPIO_WritePin(TRIG_GPIO_Port, TRIG_Pin, GPIO_PIN_RESET);
	HAL_TIM_IC_Start_IT(&htim9, TIM_CHANNEL_1);
	uint32_t startTick = HAL_GetTick();
	uint32_t tick_difference = HAL_GetTick() - startTick;
	while (tick_difference < ULTRASONIC_TIMEOUT_MS)
	{
		if (IC_flag == 1)
			break;
		else
			tick_difference = HAL_GetTick() - startTick;
	}
	HAL_TIM_IC_Stop_IT(&htim9, TIM_CHANNEL_1);
	if(IC_flag == 1 && IC_time2 > IC_time1 && tick_difference < ULTRASONIC_TIMEOUT_MS)
	{
		ultrasonic_distance_cm = (IC_time2 - IC_time1) * speed_of_sound;
	}
	if (ultrasonic_distance_cm > ULTRASONIC_MAX_DISTANCE_CM)
		ultrasonic_distance_cm = ULTRASONIC_MAX_DISTANCE_CM;
	else if (ultrasonic_distance_cm < ULTRASONIC_MIN_DISTANCE_CM)
		ultrasonic_distance_cm = ULTRASONIC_MIN_DISTANCE_CM;
	IC_flag = 0;
}
void read_sbus()
{
	uint8_t i = 0;
	if(rxUART6[0] == SBUS_START && rxUART6[24] == SBUS_END)
	{
		//failsafe
		rc_frame_lost = (rxUART6[i+23] & 0x04) >> 2;
		rc_failsafe = (rxUART6[i+23] & 0x08) >> 3;
		//16 channels, 11bit per channel
		rc_in_raw[0] = (rxUART6[i+1] | rxUART6[i+2] << 8) & 0x07ff;
		rc_in_raw[1] = (rxUART6[i+2] >> 3 | rxUART6[i+3] << 5) & 0x07ff;
		rc_in_raw[2] = (rxUART6[i+3] >> 6 | rxUART6[i+4] << 2 | rxUART6[i+5] << 10) & 0x07ff;
		rc_in_raw[3] = (rxUART6[i+5] >> 1 | rxUART6[i+6] << 7) & 0x07ff;
		rc_in_raw[4] = (rxUART6[i+6] >> 4 | rxUART6[i+7] << 4) & 0x07ff;
		rc_in_raw[5] = (rxUART6[i+7] >> 7 | rxUART6[i+8] << 1 | rxUART6[i+9] << 9) & 0x07ff;
		rc_in_raw[6] = (rxUART6[i+9] >> 2 | rxUART6[i+10] << 6) & 0x07ff;
		rc_in_raw[7] = (rxUART6[i+10] >> 5 | rxUART6[i+11] << 3) & 0x07ff;
		rc_in_raw[8] = (rxUART6[i+12] | rxUART6[i+13] << 8) & 0x07ff;
		rc_in_raw[9] = (rxUART6[i+13] >> 3 | rxUART6[i+14] << 5) & 0x07ff;
		rc_in_raw[10] = (rxUART6[i+14] >> 6 | rxUART6[i+15] << 2 | rxUART6[i+16] << 10) & 0x07ff;
		rc_in_raw[11] = (rxUART6[i+16] >> 1 | rxUART6[i+17] << 7) & 0x07ff;
		rc_in_raw[12] = (rxUART6[i+17] >> 4 | rxUART6[i+18] << 4) & 0x07ff;
		rc_in_raw[13] = (rxUART6[i+18] >> 7 | rxUART6[i+19] << 1 | rxUART6[i+20] << 9) & 0x07ff;
		rc_in_raw[14] = (rxUART6[i+20] >> 2 | rxUART6[i+21] << 6) & 0x07ff;
		rc_in_raw[15] = (rxUART6[i+21] >> 5 | rxUART6[i+22] << 3) & 0x07ff;
		for(uint8_t i = 0; i < SBUS_CHANNELS; i++)
		{
			rc_in[i] = (5 * rc_in_raw[i] / 8) + 880;//int to float
		}
		rc_bad_frame = 0;
		if(last_state_rcin6 <= 1900 && rc_in[6] > 1900)
			begin_tracking = 1;
		last_state_rcin6 = rc_in[6];
	}
	else
	{
		rc_bad_frame = 1;
		HAL_UART_AbortReceive(&huart6);
		HAL_UART_Receive_DMA(&huart6, (uint8_t *)rxUART6, sbus_receive_length);
	}
}
void write_sbus()
{
	//float to int
	for(uint8_t i = 0; i < SBUS_CHANNELS; i++)
	{
		//rc_in[i] = (5 * rc_in_raw[i] / 8) + 880;
		rc_out_raw[i] = (rc_out[i] - 880) * 8 / 5;
		if (rc_out_raw[i] < SBUS_CHANNEL_MIN)
			rc_out_raw[i] = SBUS_CHANNEL_MIN;
		if (rc_out_raw[i] > SBUS_CHANNEL_MAX)
			rc_out_raw[i] = SBUS_CHANNEL_MAX;
	}

	txUART5[0] = SBUS_START;
	//16 channels, 11bit per channel
	txUART5[1] = ((rc_out_raw[0] & 0x07ff));
	txUART5[2] = ((rc_out_raw[0] & 0x07ff) >> 8 | (rc_out_raw[1] & 0x07ff) << 3);
	txUART5[3] = ((rc_out_raw[1] & 0x07ff) >> 5 | (rc_out_raw[2] & 0x07ff) << 6);
	txUART5[4] = ((rc_out_raw[2] & 0x07ff) >> 2);
	txUART5[5] = ((rc_out_raw[2] & 0x07ff) >> 10 | (rc_out_raw[3] & 0x07ff) << 1);
	txUART5[6] = ((rc_out_raw[3] & 0x07ff) >> 7 | (rc_out_raw[4] & 0x07ff) << 4);
	txUART5[7] = ((rc_out_raw[4] & 0x07ff) >> 4 | (rc_out_raw[5] & 0x07ff) << 7);
	txUART5[8] = ((rc_out_raw[5] & 0x07ff) >> 1);
	txUART5[9] = ((rc_out_raw[5] & 0x07ff) >> 9 | (rc_out_raw[6] & 0x07ff) << 2);
	txUART5[10] = ((rc_out_raw[6] & 0x07ff) >> 6 | (rc_out_raw[7] & 0x07ff) << 5);
	txUART5[11] = ((rc_out_raw[7] & 0x07ff) >> 3);
	txUART5[12] = ((rc_out_raw[8] & 0x07ff));
	txUART5[13] = ((rc_out_raw[8] & 0x07ff) >> 8 | (rc_out_raw[9] & 0x07ff) << 3);
	txUART5[14] = ((rc_out_raw[9] & 0x07ff) >> 5 | (rc_out_raw[10] & 0x07ff) << 6);
	txUART5[15] = ((rc_out_raw[10] & 0x07ff) >> 2);
	txUART5[16] = ((rc_out_raw[10] & 0x07ff) >> 10 | (rc_out_raw[11] & 0x07ff) << 1);
	txUART5[17] = ((rc_out_raw[11] & 0x07ff) >> 7 | (rc_out_raw[12] & 0x07ff) << 4);
	txUART5[18] = ((rc_out_raw[12] & 0x07ff) >> 4 | (rc_out_raw[13] & 0x07ff) << 7);
	txUART5[19] = ((rc_out_raw[13] & 0x07ff) >> 1);
	txUART5[20] = ((rc_out_raw[13] & 0x07ff) >> 9 | (rc_out_raw[14] & 0x07ff) << 2);
	txUART5[21] = ((rc_out_raw[14] & 0x07ff) >> 6 | (rc_out_raw[15] & 0x07ff) << 5);
	txUART5[22] = ((rc_out_raw[15] & 0x07ff) >> 3);
	txUART5[23] = ((rc_failsafe & 0x01) << 3) | ((rc_frame_lost & 0x01) << 2);
	txUART5[24] = SBUS_END;
}
void sbus_passthrough()
{
	if (object_tracking == 1)
	{
//		rc_out[0] = rc_in[0];//thr
		rc_out[0] = control_thr;//thr
		rc_out[1] = rc_in[1];//roll
//		rc_out[2] = rc_in[2];//pitch
		if(target_locked==1)
			rc_out[2] = control_pitch;
		else
			rc_out[2] = rc_in[2];//pitch
//		rc_out[3] = rc_in[3];//yaw
		rc_out[3] = control_yaw;//yaw
		rc_out[4] = rc_in[4];
		rc_out[5] = rc_in[5];
		rc_out[6] = rc_in[6];
		rc_out[7] = rc_in[7];
		rc_out[8] = rc_in[8];
		rc_out[9] = rc_in[9];
		rc_out[10] = rc_in[10];
		rc_out[11] = rc_in[11];
		rc_out[12] = rc_in[12];
		rc_out[13] = rc_in[13];
		rc_out[14] = rc_in[14];
		rc_out[15] = rc_in[15];
	}
	else
	{
		for (uint8_t i = 0; i < SBUS_CHANNELS; i++)
		{
			rc_out[i] = rc_in[i];
		}
	}
	for(uint8_t i = 0; i < SBUS_CHANNELS; i++)
	{
		if (rc_out_raw[i] < RC_MIN)
			rc_out_raw[i] = RC_MIN;
		if (rc_out_raw[i] > RC_MAX)
			rc_out_raw[i] = RC_MAX;
	}
}
void init_variables()
{
	pid_altitude.plusminus=1;
	pid_altitude.Kp = P_altitude;
	pid_altitude.Ki = I_altitude;
	pid_altitude.Kd = D_altitude;
	pid_altitude.T = 0.1;
	pid_altitude.tau = D_FILTER_TIME_CONSTANT;
	pid_altitude.lim_min = PID_MIN_ALT;
	pid_altitude.lim_max = PID_MAX_ALT;
	pid_altitude.lim_min_int = PID_MIN_ALT_I;
	pid_altitude.lim_max_int = PID_MAX_ALT_I;

	pid_angle.plusminus=-1;
	pid_angle.Kp = P_angle;
	pid_angle.Ki = I_angle;
	pid_angle.Kd = D_angle;
	pid_angle.T = 0.1;
	pid_angle.tau = D_FILTER_TIME_CONSTANT;
	pid_angle.lim_min = PID_MIN;
	pid_angle.lim_max = PID_MAX;
	pid_angle.lim_min_int = PID_MIN;
	pid_angle.lim_max_int = PID_MAX;

	pid_distance.plusminus=-1;
	pid_distance.Kp = P_distance;
	pid_distance.Ki = I_distance;
	pid_distance.Kd = D_distance;
	pid_distance.T = 0.1;
	pid_distance.lim_min = PID_MIN;
	pid_distance.lim_max = PID_MAX;
	pid_distance.lim_min_int = PID_MIN;
	pid_distance.lim_max_int = PID_MAX;

	f_uwb1_cm.filter_size = UWB_FILTER_SIZE;
//	f_uwb1_cm.moving_sum = 0.0f;

	f_uwb2_cm.filter_size = UWB_FILTER_SIZE;
//	f_uwb2_cm.moving_sum = 0.0f;

	f_usonic_cm.filter_size = USONIC_FILTER_SIZE;
//	f_usonic_cm.moving_sum = 0.0f;

	f_trig_angle_deg.filter_size = TRIG_ANGLE_FILTER_SIZE;
//	f_trig_angle_deg.filter_size = 3;
//	f_trig_angle_deg.moving_sum = 0.0f;
//	f_trig_angle_deg.buf_size = 0;
//	f_trig_angle_deg.window_index = 0;

	f_trig_distance_cm.filter_size = TRIG_DISTANCE_FILTER_SIZE;
//	f_trig_distance_cm.moving_sum = 0.0f;
//	f_trig_distance_cm.buf_size = 0;
//	f_trig_distance_cm.window_index = 0;
//	for(uint8_t i=0;i<MAX_FILTER_SIZE;i++)
//	{
//		f_trig_angle_deg.buf[i]=0;
//		f_trig_distance_cm.buf[i]=0;
//	}

	//	float value;
	//	float moving_sum;
	//	uint8_t window_index;
	//	float buf[MAX_FILTER_SIZE];
	//	uint8_t buf_size;
	//	uint8_t filter_size;
}
void moving_average_update_float(float input, struct f_float *s)
{
	s->moving_sum = s->moving_sum - s->buf[s->window_index] + input;
	s->buf[s->window_index] = input;
	s->window_index++;
	if (s->window_index > s->filter_size - 1)
	{
		s->window_index = 0;
		s->buf_size = s->filter_size;
	}
	if (s->buf_size == s->filter_size)
	{
		s->value = s->moving_sum / s->filter_size;
	}
}
void update_trig(float B, float A)
{
	//             degC
	//            * *  *
	//          *    *  *
	//        *      *   *
	//     rx1(B)     *    rx2(A)
	//     *          *      *
	//   *             *       *
	//  *              *degA1    *
	//degA*****rx12(C)*****rx12/2**degB
	if (B > A + UWB_RX_TO_RX_DISTANCE_CM)
	{
		trig_rho_est_cm = (A+B)/2;
		trig_theta_est_deg = -90;
	}
	else if (A > B + UWB_RX_TO_RX_DISTANCE_CM)
	{
		trig_rho_est_cm = (A+B)/2;
		trig_theta_est_deg = 90;
	}
	else
	{
		float C = UWB_RX_TO_RX_DISTANCE_CM;
		float C_div_2 = UWB_RX_TO_RX_DISTANCE_CM/2;
		float C_div_2_pow_2 = pow(C_div_2,2);
		float A_pow_2 = pow(A,2);
		float radA1 = acos((A_pow_2+pow(C,2)-pow(B,2))/(2*A*C));
		trig_rho_est_cm = sqrt(A_pow_2+C_div_2_pow_2-2*A*C_div_2*cos(radA1));
		trig_theta_est_deg = conv_to_deg*acos((pow(trig_rho_est_cm,2)+C_div_2_pow_2-A_pow_2)/(2*trig_rho_est_cm*C_div_2))-90;
	}
}
void init_log_microsd()
{
	//memset(microsd_buf,0,MICROSD_BUFFER_SIZE);
	//sdcard buffer up to 128 bytes. After 120 bytes wait at least 44ms
	microsd_buf[0]=0x0d;
	microsd_buf[1]=0x0a;
	HAL_UART_Transmit(&huart3, (uint8_t *)microsd_buf, 2, 10);
	//HAL_Delay(100);//wait for card
	snprintf(microsd_buf, MICROSD_BUFFER_SIZE, "%s\r\n", "New log begin");
	HAL_UART_Transmit(&huart3, (uint8_t *)microsd_buf, 14, 10);
	HAL_Delay(100);//wait for card
	snprintf(microsd_buf, MICROSD_BUFFER_SIZE, "%s\r\n", "P_angle;I_angle;D_angle;"
			"P_distance;I_distance;D_distance;P_altitude;I_altitude;D_altitude");
	HAL_UART_Transmit(&huart3, (uint8_t *)microsd_buf, 91, 10);
	HAL_Delay(100);//wait for card
	snprintf(microsd_buf, MICROSD_BUFFER_SIZE, "%1.4f;%1.4f;%1.4f;%1.4f;%1.4f;%1.4f;%1.4f;%1.4f;%1.4f;\r\n",
			pid_angle.Kp,pid_angle.Ki,pid_angle.
			Kd,pid_distance.Kp,pid_distance.Ki,pid_distance.Kd,
			pid_altitude.Kp,pid_altitude.Ki,pid_altitude.Kd);
	HAL_UART_Transmit(&huart3, (uint8_t *)microsd_buf, 65, 10);
	HAL_Delay(100);//wait for card
//	snprintf(microsd_buf, MICROSD_BUFFER_SIZE, "%s\r\n", "uwb1;uwb2;usnic;"
//			"angle;dist;"
//			"angleErr;distErr;altErr;"
//			"anglePidsum;distPidsum;altPidsum;"
//			"altPsum,altIsum,altDsum"
//			"trck;tme;pktLss1;pktLss2");
//	snprintf(microsd_buf, MICROSD_BUFFER_SIZE, "%s\r\n", "uwb1;uwb2;usnic;"
//			"angle;dist;"
//			"angleErr;distErr;altErr;"
//			"anglePidsum;distPidsum;altPidsum;"
//			"anglePsum,angleIsum,angleDsum"
//			"trck;tme;pktLss1;pktLss2");
	snprintf(microsd_buf, MICROSD_BUFFER_SIZE, "%s\r\n", "uwb1;uwb2;usnic;"
				"angle;dist;"
				"angleErr;distErr;altErr;"
				"anglePidsum;distPidsum;altPidsum;"
				"distPsum,distIsum,distDsum"
				"trck;tme;pktLss1;pktLss2;trg_l");
	HAL_UART_Transmit(&huart3, (uint8_t *)microsd_buf, 110, 10);
}
void update_log_microsd()
{
	memset(microsd_buf,0,MICROSD_BUFFER_SIZE);
	snprintf(microsd_buf, MICROSD_BUFFER_SIZE, "%4.1f;%4.1f;%3.1f;"
					"%3.1f;%4.1f;"
					"%3.1f;%4.1f;%3.1f;"
					"%3.1f;%3.1f;%3.1f;"
					"%3.1f;%3.1f;%3.1f;"
					"%d;%d;%d;%d;%d\r\n",f_uwb1_cm.value,f_uwb2_cm.value,f_usonic_cm.value,
					f_trig_angle_deg.value,f_trig_distance_cm.value,
					pid_angle.error,pid_distance.error,pid_altitude.error,
					pid_angle.pidsum,pid_distance.pidsum,pid_altitude.pidsum,
					pid_distance.psum,pid_distance.isum,pid_distance.dsum,
					object_tracking,time_10hz,dwm_loc_get1.packet_loss[0],dwm_loc_get2.packet_loss[0],target_locked
					);
//	snprintf(microsd_buf, MICROSD_BUFFER_SIZE, "%4.2f;%4.2f;%3.2f;"
//				"%3.2f;%4.2f;"
//				"%3.2f;%4.2f;%3.2f;"
//				"%3.2f;%3.2f;%3.2f;"
//				"%d;%d;%d;%d\r\n",f_uwb1_cm.value,f_uwb2_cm.value,f_usonic_cm.value,
//				f_trig_angle_deg.value,f_trig_distance_cm.value,
//				pid_angle.error,pid_distance.error,pid_altitude.error,
//				pid_angle.pidsum,pid_distance.pidsum,pid_altitude.pidsum,
//				object_tracking,time_10hz,dwm_loc_get1.packet_loss[0],dwm_loc_get2.packet_loss[0]
//				);
//	snprintf(microsd_buf, MICROSD_BUFFER_SIZE,
//			"0:%4.2f;00:%4.2f;"
//			"1:%3.2f;2:%4.2f;"
//			"3:%3.2f;4:%4.2f;"
//			"5:%d;6:%d;"
//			"7:%6.2f;8:%d;"
//			"9:%3.2f;10:%3.2f;11:%3.2f;\r\n",
//			f_uwb1_cm.value,f_uwb2_cm.value,
//			f_trig_angle_deg.value,f_trig_distance_cm.value,
//			trig_theta_est_deg, trig_rho_est_cm,
//			f_trig_angle_deg.buf_size,f_trig_angle_deg.filter_size,
//			f_trig_angle_deg.moving_sum,f_trig_angle_deg.window_index,
//			f_trig_angle_deg.buf[0],f_trig_angle_deg.buf[1],f_trig_angle_deg.buf[2]
//			);
	for(uint16_t i=0;i<=MICROSD_BUFFER_SIZE-1;i++)
	{
		if(microsd_buf[i] == 0x0A)//ascii \n
		{
			microsd_buf_size = i+1;
			break;
		}
	}
	HAL_UART_Transmit(&huart3, (uint8_t *)microsd_buf, microsd_buf_size, 10);
}
void write_periodic_LCD()
{
	txUART4[0] = DISPLAY_START_PERIODIC;
	uint8_t angle_plus_90=roundf(f_trig_angle_deg.value+90);
//	uint8_t angle_plus_90=roundf(trig_theta_est_deg+90);
	txUART4[1] = (uint8_t)angle_plus_90;
	uint16_t distance = f_trig_distance_cm.value;//conversion from float
	txUART4[2] = distance >> 8;
	txUART4[3] = distance & 0x00FF;
	uint16_t altitude = f_usonic_cm.value;//conversion from float
	txUART4[4] = altitude >> 8;
	txUART4[5] = altitude & 0x00FF;
	uint16_t uwb1 = f_uwb1_cm.value;//conversion from float
	uint16_t uwb2 = f_uwb2_cm.value;//conversion from float
	txUART4[6] = uwb1 >> 8;
	txUART4[7] = uwb1 & 0x00FF;
	txUART4[8] = uwb2 >> 8;
	txUART4[9] = uwb2 & 0x00FF;
	txUART4[10] = 0xFF;//termination byte1
	txUART4[11] = 0xFF;//termination byte2
	txUART4[12] = 0xFF;//termination byte3
}
float constrain_f(float input, float min, float max)
{
	float output;
	if(input > max)
	{
		output = max;
	}
	else if (input < min)
	{
		output = min;
	}
	return output;
}
void init_PID(struct pid *s)
{
	s->isum = 0.0f;
	s->last_error  = 0.0f;
	s->dsum  = 0.0f;
	s->last_meas = 0.0f;
	s->pidsum = 0.0f;
}
void calculate_PID(float measurement, float setpoint, struct pid *s)
{
    //float error = setpoint - measurement;
	s->error = setpoint - measurement;
    s->psum = s->Kp * s->error;
    s->isum = s->isum + 0.5f * s->Ki * s->T * (s->error + s->last_error);
    if (s->isum > s->lim_max_int)
    {
        s->isum = s->lim_max_int;
    }
    else if (s->isum < s->lim_min_int)
    {
        s->isum = s->lim_min_int;
    }
    s->dsum = -(2.0f*s->Kd*(measurement-s->last_meas)+(2.0f*s->tau-s->T)*s->dsum)/(2.0f*s->tau+s->T);
    s->pidsum = s->psum + s->isum + s->dsum;
    if (s->pidsum > s->lim_max)
    {
        s->pidsum = s->lim_max;
    }
    else if (s->pidsum < s->lim_min)
    {
        s->pidsum = s->lim_min;
    }
    s->last_error = s->error;
    s->last_meas = measurement;
}
void parse_uwb_uart(struct loc *loc, uint8_t bfr[])
{
	if (bfr[0]==0x44 && bfr[10]==0x0D && bfr[11]==0x0A && bfr[9]==0x41)
	{
		uint8_t tmp[8];
		for(uint8_t i=0;i<=7;i++)
		{
		  tmp[i]=bfr[i+1];
		}
		sscanf(tmp,"%08lx",&loc->distance_to_anchor[0]);
			loc->distance_to_anchor_cm[0] = (float)loc->distance_to_anchor[0]/10;
			loc->uwb_ok[0] = 1;
			if(loc->packet_sum[0] < UWB_PACKET_BUFFER_SIZE)
				loc->packet_sum[0]++;

		loc->packet_loss[0] = 100-loc->packet_sum[0]*100/UWB_PACKET_BUFFER_SIZE;
	}
	else
	{
		loc->uwb_ok[0] = 0;
		if(loc->packet_sum[0] > 0)
			loc->packet_sum[0]--;

	}
}
/* USER CODE END 4 */
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
