arvtom/uwb_trac/UWB pcb/UWB pcb.ioc

Mcu.UserName=STM32F732VETx
PA0-WKUP.Signal=UART4_TX
PA1.Signal=UART4_RX
PA11.GPIO_Label=LD2
PA11.Signal=GPIO_Output
PA12.GPIO_Label=LD3
PA12.Signal=GPIO_Output
PA13.Signal=SYS_JTMS-SWDIO
PA14.Signal=SYS_JTCK-SWCLK
PB10.Signal=USART3_TX
PB11.Signal=USART3_RX
PB3.Signal=SYS_JTDO-SWO
PC12.Signal=UART5_TX
PC6.Signal=USART6_TX
PC7.Signal=USART6_RX
PD2.Signal=UART5_RX
PE0.Signal=UART8_RX
PE1.Signal=UART8_TX
PE4.GPIO_Label=TRIG
PE4.Signal=GPIO_Output
PE5.Signal=S_TIM9_CH1
PE7.Signal=UART7_RX
PE8.Signal=UART7_TX
PH0-OSC_IN.Signal=RCC_OSC_IN
PH1-OSC_OUT.Signal=RCC_OSC_OUT
