arvtom/uwb_trac/UWB pcb/Core/Inc/main.h

#define TRIG_Pin GPIO_PIN_4
#define TRIG_GPIO_Port GPIOE
#define LD2_Pin GPIO_PIN_11
#define LD2_GPIO_Port GPIOA
#define LD3_Pin GPIO_PIN_12
#define LD3_GPIO_Port GPIOA
